crxguy52/pi-car-power-supply/tools/post_route/README.md

# tools/post_route: recorded edits to the master

These scripts are the record of each edit: pcbnew edits to `pi_power_board.kicad_pcb` (KiCad python, saved next to the `.kicad_pro`). **Run only a new script, or one marked re-runnable.** Every other script is history: re-run on today's master it stops at its guard at best, and at worst undoes later hand edits.

Each script: docstring = what, why, SPEC section; copies the master to `pi_power_board-backups/` with a timestamp first (no git); stops on any unexpected state; leaves every other item untouched; idempotent; every KiCad call under `timeout`.

State legend: **re-runnable** (safe to run again) · **applied-once** (record; stops at its guard) · **refuses** (blocks itself on the current master) · **historical** (kept for reference only).

| # | Script | What | State |
|---|---|---|---|
| 01 | `01_update_from_schematic.py` | Board from the schematic netlist (SPEC 7): K1/U2/R10 removed; every schematic footprint re-loaded from the library at its position (J1/J4/J5 Metz → Phoenix MKDS with identical pad coordinates, U3/U8/D1/D2/L1 swaps, KiCad 10 library drift); 44 new parts staged off-board; Path/Sheetname/fields; every pad net from the netlist; uuid5 uuids. DRC parity 0 | **historical** (names parts removed by the CD4541B design; its netlist export reads the live schematic: superseded by 05) |
| 02 | `02_placement.py` | Placement at 1206 (target list + courtyard legalizer, refdes on silk where free, J1/J4/J5 pin-name silk). Board full: R11/D1/D4/D5 parked off-board. **Superseded by 03**; its helpers (legalizer search, `place_refs`, pin labels) are imported by 03 | **historical** (a re-run would undo 03's placement: don't) |
| 03 | `03_0805_replace.py` | 31 passives swapped 1206 -> 0805 in place (01's helpers: fields, Path, nets, uuid5) and every movable part re-placed: anchors (buck, power path, SW1, C12, U4/C9) legalized from TARGETS, the rest by seeded annealing (net length + placement RULES + distance from TARGETS) and a staged legalizer; GAP 0.5 mm, fallback 0.25 mm. All 64 parts top side, 43 at >= 0.5 mm gaps (staff review 2026-11-04: C15/C18 targets swapped, C3 rule) DRC 0 violations, parity 0 | **historical** (its TARGETS name removed parts: stops at its guard; superseded by 06) |
| 04 | `04_buck_route.py` + `route_lib.py` | Routing attempt for the old 64-part design (A4, 2026-11-04 night), stopped by the project lead before it ran (board mtime = 03). **Never run; obsolete**: the simplified redesign (SPEC 7, 2026-11-04) removes most of the parts it routes | **historical** (never run: don't) |
| 05 | `05_sync_cd4541.py` | Board from the **frozen** netlist `build/placement_netlist_snapshot.xml` (44 parts, CD4541B design, SPEC 7; the schematic is not read): 36 old parts removed, 13 new added (Path, Sheetname/Sheetfile, fields; staged off-board), 13 re-loaded from the library (C22-C24 1206 -> 1210, changed values / nets / fields), every pad net set, Sim.* fields ignored; then J1, J4, J5 rotated 180 deg about their pad rows (lead decision 2026-11-05: wire entries outward; same pad locations, pin order reversed, nets follow pins). 01's helpers imported read-only. DRC parity 0 | **re-runnable** (prints "already applied") |
| 06 | `06_placement.py` | Placement of the 40 movable parts: ANCHORS (power corner Q1/C30/R14/TVS1, buck row U8/C17/C15/C22-C24/L1/C18) exact, the rest legalized from TARGETS (gap 1.0 mm, fallback 0.75 / 0.5 mm, staged search radius, outside the planned power channels); refs on silk where unambiguous, else F.Fab; J1/J4/J5 pin labels for the new pin order. `--dry-run [--out scratch.kicad_pcb]` never saves the master | **historical since 07** (a re-run would undo 07's turns and the C18 shift: don't; re-placing = a new script) |
| 07 | `07_placement_review.py` | Placement staff review fixes (2026-11-05): D4 Path re-linked to the snapshot symbol uuid (05 kept the old one: `fp_matches` doesn't compare Path); R30, D4, R3 turned 180 deg in place (pad toward the rest of its net; references kept where 06 put them); C18 0.5 mm down (U8 gap 0.53 -> 1.03 mm). Guarded on the 06 positions; `--dry-run` never saves | **re-runnable** (prints "already applied") |
| 08 | `08_lead_layout.py` + `lead_layout_2026-11-05.json` | The project lead's layout tweaks (32 parts moved in `pi-car-power-supply - Copy`): `--snapshot` (once) writes positions, rotations, ref/value text, Path and pad nets to the JSON; the apply mode moves the master's parts by reference, guarded (same refs, footprint ids, Paths, pad nets). J2 / J5 moved by the lead: baseline via `check_fixed.py --accept-lead-change J2,J5` (pure translation). ADJUST: R16 to the VSENSE side, D3 + R3 below the compensation parts, R15 above Q5, Q5 +0.5 mm, C19 -0.1 mm (DECISIONS "Lead layout adopted") | **re-runnable** (prints "already applied") |
| 09 | `09_buck_route.py` | Net classes / board rules in `.kicad_pro`; buck (hot loop, PH by vias, BOOT, VSENSE sense line along the GPIO-notch edge, FB / SS / COMP / CRC), power pours `BATT_TOP`, `VOUT_TOP`, `VOUT_BOT`, `P5V_TOP`, J2 VBUS necks, ACC_IN J1 -> TVS2 -> D5, TVS returns, Q1_G, Q1 tab vias (2 x 1.0 mm feed + 21 thermal) and a B.Mask opening over the tab; all locked | **applied-once since 12** (12 moved its sense line: a re-run stops at its "partly applied" guard; its BOARD_RULES copper-to-edge 0.3 mm is superseded by 12's 0.4 mm) |
| 10 | `10_freeroute.py` + `10_ledger.json` | GND fan-out vias (16 SMD pads), DSN (09 zones as keep-outs, completed nets reduced to one pin, BATT -> SW1 feed only, 0.5 mm), Freerouting 2.5.0 headless, SES import (locked copper checked unchanged) | **re-runnable** (prints "already applied") |
| 11 | `11_cleanup.py` + `11_ledger.json` | Review of the Freerouting output (neck-downs widened to 0.25 mm, its vias 0.6 / 0.3, snap, zero-length, acute angles, no Freerouting copper on power nets but the SW1 feed); J2 inner GND pin ties; `GND_TOP` / `GND_BOT` pours; 5 mm stitching grid; refs over pads / silk to F.Fab; all locked | **re-runnable** (prints "already applied") |
| 12 | `12_osh_rules.py` + `pi_power_board.kicad_dru` | Routing staff review (2026-11-05): fab = OSH Park 2-layer. Board Setup floors in `.kicad_pro` (copper to edge 0.4, track / space 0.1524, ring 0.127, drill 0.254, via 0.508, hole to hole 0.127, text 0.0762 mm), `.kicad_dru` min slot 0.508 mm, mask expansion 0.0762 / min web 0.1016 mm, stackup (text patch, 1.6256 mm), `+5V1` sense run 0.1 mm off the GPIO-notch edge, refill. Apply stage runs in a fresh process (a loaded project keeps the old rules for the fill). `--dry-run`; `--root DIR` (scratch copy); `--root DIR --selftest-dru` (proves the slot rule) | **re-runnable** (prints "already applied") |
| 13 | `13_right_notch.py` | Project lead decision 2026-11-05: the BACK HEADER KEEPOUT strip on the right edge cut out (x 185.166–192.024, y 70.450–102.000; inner fillets r 1.524, outer corners r 0.762; geometry recorded in `check_fixed.RIGHT_NOTCH_PATH`). Top cut edge 10 µm below the approved 70.440 so the MH2 neck is ≥ 5 mm (measured 5.009 top / 5.024 bottom mm). 7 GND stitching vias in the strip (x 189.47) deleted; 5 at x 184.47 next to the new inner edge moved to x 184.2 (edge gap 0.666 mm); J1 / J4 pin labels x 184.4 → 184.33 (edge gap 0.157 mm); refill; `check_fixed --accept-lead-change EDGE_RIGHT_NOTCH`. `--dry-run` | **historical since 14** (14 replaced its top edge: a re-run stops at its "partly applied" guard) |
| 14 | `14_notch_under_usb.py` | Project lead decision 2026-11-05 ("keep board under the USB port J2"): the notch's top edge moved from y 70.450 to `check_fixed.CUT_TOP_Y_USB` = 85.000, just below J2's courtyard (84.555; limit courtyard + 0.2 mm). The five top path items (right edge line, mouth arc r 0.762, top edge, inner fillet r 1.524, inner vertical line) replaced by `check_fixed.RIGHT_NOTCH_USB_TOP`, exact shared endpoints; bottom edge unchanged. Built and refilled in a scratch copy (`C:\tmp\pipwr\a19_14`), then copied over the master. 3 GND stitching vias back at x 189.47 (11's grid, y 70.89 / 75.89 / 80.89; edge, fill and hole checks). Necks 19.170 top / 5.024 bottom mm; J2 pad copper to edge 1.336 mm; J1 / J4 labels untouched. `check_fixed --accept-lead-change EDGE_RIGHT_NOTCH_UNDER_USB`. `--dry-run` | **re-runnable** (prints "already applied") |
| 15 | `15_sync_fields.py` | Final reconcile with the schematic (fresh netlist `build/netlist.xml`, exclude_from_board simulation parts skipped): Value (D3 `VFR1105W`, J5 `ACC_N GND`), Datasheet, Description, Manufacturer, MPN, Digi-Key PN and Sim.* (KiCad 10 parity compares them) copied onto every footprint; missing fields inserted hidden on F.Fab (silk unchanged); Path / Sheetname / Sheetfile checked against the netlist tstamps (all 44 matched). Guarded: footprint set, footprint ids, pad nets, positions unchanged; stops on a visible silk Value. 2026-11-05: 165 inserts, 72 updates, 2 values, 0 Paths; DRC parity 0. `--dry-run` | **re-runnable** (prints "already applied"; 2026-11-06 after 16: 46 footprints match) |
| 16 | `16_buck_layout.py` | U8 datasheet review (2026-11-06, SLVSCD5D 10.1): fields of L1 / R16 / R17 / R18 and new C31 / C32 from a fresh netlist (Path, fields, pad nets, uuid5); U8 + C17 + C15 + their copper moved as one block (−1.3, +9.205 mm) below J5; R16 / R17 at pin 5, R18 / C20 at pin 6, C19 at pin 8 (F.Cu); analog ground traces to the PowerPAD + rule area `AGND_KEEPOUT` (F.Cu, no fill); C18 at BOOT (PH via right of it), C31 below C15, C32 left of C22, L1 +1 mm; PH B.Cu re-run; old FB / COMP / CRC / SS / BOOT copper deleted; `+5V1` sense ends at R16; VOUT_TOP / P5V_TOP outlines; refs of moved parts, U8 Value and D3 ref to F.Fab; refill. DRC 0 errors / 0 unconnected / 0 parity; `check_fixed` PASS. `--dry-run`, `--root DIR` | **re-runnable** (prints "already applied") |
| 17 | `17_silk_refs.py` | Project lead review 2026-11-09, run after the lead's own GUI edits of the buck block (output caps left, L1 turned, third PH via, C17 / R17): every visible F.Fab reference to F.Silkscreen (0.8 / 0.12 mm), at the nearest spot clear of pads, vias, silk, other parts' bodies and the edge, then a second pass re-places any label nearer another part's courtyard than its own (staff review: U8 read as D3's, C31 as C18's); no spot = left on silk at the courtyard centre for the lead (C18, R16: DRC `silk_over_copper` warnings). Debris: 9 micro-segments (≤ 50 µm kinks / zero-length dots on GND, FB, PH, `U5_RS`, `ACC_G`) deleted with the neighbour ends snapped together (clearance-checked) and collinear contained segments; refill. DRC 0 errors / 0 unconnected / 0 parity; `check_fixed` PASS. `--dry-run`, `--root DIR` | **re-runnable** (prints "already applied") |
| 18 | `18_thermals.py` | Project lead 2026-11-09 (hand soldering without a preheat station for every part): every pour's pad connection THT-only / solid -> thermal relief (spokes 0.5 mm, gap 0.3 mm, unchanged); solid overrides on U8 (PowerPAD; VIN / GND hot loop), Q1 (tab heatsink), C17 (hot-loop input cap) and C32 pad 1 (one spoke fits at the P5V_TOP strip end: starved_thermal); refill. DRC 0 errors / 0 unconnected / 0 parity; `check_fixed` PASS. `--dry-run`, `--root DIR` | **re-runnable** (prints "already applied") |

**2026-11-05 routing:** 08 adopted the lead's layout, 09-11 routed the board (DRC 0 errors / 0 unconnected; DECISIONS "Routing"). Re-routing = restore the backup taken before 09 and re-run 09-11 (Freerouting's result is reproducible on the same input board, but check it), then 12. Staff review: 12 (DECISIONS "Fab = OSH Park", "Routing staff review").

Renders (no script; kicad-cli under timeout, from the project root): `pcb export svg --mode-single --page-size-mode 2 --exclude-drawing-sheet -l F.Cu,F.Mask,F.Silkscreen,Edge.Cuts` (bottom: `--mirror -l B.Cu,B.Mask,B.Silkscreen,Edge.Cuts`), rasterized with PyMuPDF to 2048 px wide -> `reports/routed_top.png` / `routed_bottom.png`; `pcb render --side top --width 1712 --height 1432 --quality high` -> `reports/routed_3d_top.png`.

**2026-11-05 CD4541B design:** 05 rebuilt the board from the frozen netlist snapshot, 06 placed it (DECISIONS 2026-11-05 "Placement") and 07 applied the placement staff review (DECISIONS "Placement staff review"). 01-04 and 06 are history.

Guard for every script here: `tools/check_fixed.py` (KiCad python) verifies Edge.Cuts, MH1–MH4, J1/J2/J4/J5 (position, orientation, side, absolute pad coordinates, 1 µm) and the lead's drawings / rule areas against `tools/fixed_baseline.json` (generated once on 2026-11-04 from the lead's board; the generator refuses to overwrite it). The only other way it changes is a recorded lead decision, `--accept-lead-change <refs>` (guarded: every other item must pass and the change must be exactly the recorded one; the JSON keeps a `lead_changes` record): used 2026-11-05 for `J1,J4,J5` (180 deg turn about the pad rows) and `J2,J5` (the lead's layout copy: pure translations by recorded vectors) and `EDGE_RIGHT_NOTCH` (13: only the right edge line replaced by the recorded notch path) and `EDGE_RIGHT_NOTCH_UNDER_USB` (14: only the notch's five top items replaced). `--selftest` mutates each item (48 mutations; the rule-area mutations only touch the lead's rule areas, so a later keep-out such as 16's `AGND_KEEPOUT` is allowed).

Related: `tools/render_assembly.py` (KiCad python, read-only): `reports/assembly_top.png`, the top-side assembly drawing at 4:1 and 200 dpi (reference + value in each courtyard, pad 1 marked) for hand soldering, since most references don't fit on the silkscreen.
