crxguy52/pi-car-power-supply/tools/post_sch/README.md

# tools/post_sch: recorded edits to the master

These scripts are the record of each edit: text-level edits to `pi_power_board.kicad_sch`. **Run only a new script, or one marked re-runnable.** Every other script is history: re-run on today's master it stops at its guard at best, and at worst undoes later hand edits.

Each script: docstring = what, why, SPEC section; copies the master to `pi_power_board-backups/` with a timestamp first (no git); stops on any unexpected state; leaves every other item untouched; idempotent; every KiCad call under `timeout`.

State legend: **re-runnable** (safe to run again) · **applied-once** (record; stops at its guard) · **refuses** (blocks itself on the current master) · **historical** (kept for reference only).

| # | Script | What | State |
|---|---|---|---|
| 01 | `01_spec7_netlist.py` | SPEC 7 netlist of the 64-part 555 / N-FET design: K1/U2/R10 removed, every part placed, label-based wiring, PWR_FLAGs, paper A3, block headers | **historical** (2026-11-04; superseded by 03; on today's SPEC and sheet it stops at its first guard) |
| 02 | `02_0805_footprints.py` | Footprint fields of 31 small-signal passives 1206 -> 0805 HandSolder (64-part design) | **historical** (2026-11-04 overnight; superseded by 03, which writes the SPEC 7 footprints; its refs are gone, so it stops at its guard) |
| 03 | `03_simplified.py` | Simplified SPEC 7 (32 parts + J1/J2/J4/J5/SW1; U1 LM2903B): the 33 removed parts and every old wire, label, no-connect and note go; the 34 surviving parts keep their symbol and pin uuids (board link); U1 (3 units), R23, R24 added; fields from SPEC 6/7; label-stub wiring; PWR_FLAGs on BATT, GND, VOUT, +5V1; paper A4, block headers with one note each. Self-checks grid, connectivity vs SPEC 7, overlaps, A4 frame / title block; `--dry-run` writes nothing | **applied-once** (2026-11-05; since 04 it stops at its first guard: SPEC 7 has D4) |
| 04 | `04_d4_sw1_diode.py` | D4 (1N4148W) restored between SW1 pin 1 (`SW1_C`) and `ACC_S` (schematic staff review: SW1 closed with `BATT` dead back-feeds the load through D5/SW1); sheet title. Uses 03's layout engine: only SW1 pin 1's stub/label are replaced; 03's checks plus a change-set check; `--dry-run` | **applied-once** (2026-11-05; since 05 it stops at its guard: the sheet is neither the 03 nor the 04 result) |
| 05 | `05_u1_power_block.py` | U1 -> project symbol `pipwr:LM2903` (`lib/pi_power_board.kicad_sym` + `sym-lib-table`, written by the script): stock `Comparator:LM2903` with a rectangle body on the power unit C (pin 4 named GND, pin 8 V+); U1C and C8 redrawn as one block (shared `BATT` wire, one GND). Keeps U1's symbol / pin uuids. Uses 03's engine with 04's layout; 03's checks plus a change-set check; `--dry-run` | **applied-once** (2026-11-05; since 06 it stops at its guard: the sheet is neither the 04 nor the 05 result) |
| 06 | `06_timer_45s.py` | 45 s timer (project lead: ≥ 45 s worst case after the last key-off): C27, C28 (10 µF 50 V X7R 1206, the C5 part) added in parallel with C5 on `C5_T`, right of C5, 18 grid units apart (value text width); R9 2.4 → 4.7 MΩ and moved right of them; C5 / C27 / C28 fields with the GMC31X7R106K50NT MPN; timer note. Uses 03's engine with 05's layout; 03's checks plus a change-set check; `--dry-run` | **applied-once** (2026-11-05; since 08 it stops at its guard: SPEC 7 has no C5 / C27) |
| 07 | `07_low_trip_timer.py` | Low-trip 45 s timer (staff review of 06): C28 removed, R4 / R5 / R23 / R24 values, R9 moved | **historical** (never applied: the LM2903B timer was superseded first; 08 removes C28 with the rest; on today's SPEC it stops at its first guard) |
| 08 | `08_cd4541_timer.py` | CD4541B counter timer (SPEC 7, 2026-11-05 lead decisions a–c): U1, R4, R5, R9, R23, R24, C5, C27, C28 removed with every wire, label and note; 31 surviving parts keep their symbol / pin uuids; U5 (`Timer:CD4541BM`, VDD / VSS drawn to the D7 / C8 block and GND), Q5, Q6, R25–R29, C29, C30, D7 added; C8 10 µF 1206 on `VDD_TMR`, C22–C24 X7R 1210; PWR_FLAG on `VDD_TMR`; blocks Input / ACC sense, Timer U5, P-FET switch, Status / LED / Pi 12 V, Buck, USB. 03's engine and checks plus a result check (uuids kept, removed refs / nets gone, lib_symbols); `--dry-run` | **applied-once** (2026-11-05; since 09 it stops at its guard: SPEC 7 has R30 / R31) |
| 09 | `09_u5_vout_supply.py` | U5 from `VOUT` (project lead 2026-11-05: the BAT43W + 10 µF hold-up on `+5V1` failed a hard USB short): D7 becomes the BZT52C5V1 zener (`Device:D_Zener`, same ref, symbol / pin uuids and SOD-123 footprint; pin 2 `+5V1` → GND), C8 10 µF 1206 → 1 µF 0805, R30 (1206, `VOUT` → `VDD_TMR`) and R31 (0805, `VDD_TMR` → GND) added; the `VDD_TMR` rail above U5 carries U5 VDD, C8, D7, R31 and R30 as one block; block note updated. 08's layout through 03's engine; 03's checks plus a result check (08 uuids kept, D7 lib_id, lib_symbols without `Diode:BAT43W-V`); `--dry-run` | **applied-once** (2026-11-05; since 10 it stops at its guard: the sheet is neither the 08 nor the 09 result) |
| 10 | `10_u5_value_field.py` | U5 Value field ("CD4541BM96") moved from above the body (where it read as C8's part number) to below it, right of the VSS pin (staff review of 08 / 09, legibility only). 09's layout through 03's engine; 03's checks plus a result check (only the U5 symbol's Value position changes, every uuid kept); `--dry-run` | **applied-once** (2026-11-05; a re-run reports "already applied"; any other state stops) |
| 11 | `11_remove_dangling_wire.py` | Remove the orphan wire stub left by the lead's layout tidy-up (master took the lead's rearranged sheet, 2026-11-05) | applied-once |
| 12 | `12_kicad_sim.py` | KiCad-native timer sim (TODO "KiCad-native simulation"): hidden `Sim.*` fields on 26 parts (R / C built-in with numeric values, R27 / C29 / C8 with the corner factors; diodes, FETs and U5 from `lib/spice/`), `exclude_from_sim` on U8, the buck / USB passives, J1, J2, J4, J5, SW1; a sheet symbol `simulation` (excluded from board and BOM) at the bottom middle, six pins stub-wired to labels `BATT`, `ACC_IN`, `SW1_C`, `VOUT`, `ACC_N`, `+5V1`; new `simulation.kicad_sch` (battery + harness, ACC key, SW1 stand-in, Pi load, Pi GPIO pull-up, U8 stand-in, `.param` / `.tran` / `.meas`); `pipwr:SIM_2T` / `SIM_3T` in `lib/pi_power_board.kicad_sym`. Text-level, no existing item moved or changed beyond those fields (checked: uuids, positions, lib_ids, the free area); seeded uuid5; `--dry-run` | **applied-once** (2026-11-05; a re-run reports "already applied", also after 13 (guard extended by the staff review); any other state stops) |
| 13 | `13_sim_fast_review.py` | Staff review of 12: U5 `Sim.Params` + `TAPDIV={U5_TAPDIV}` (hidden Sim field only); the sim sheet's note / `.param` / analysis texts replaced in place (same uuids, positions): defaults = the fast nominal key cycle (U5 counts 2^15 / 256, 6 s transient, no interp), measurement windows as parameters (`T_CW0`, `T_CW1`, `T_VON0`), new `.meas` `u5_fall`, `osc_t1/2`, `t_osc`, `hold_est`, new `.param` `U5_TAPDIV`, `N_CNT`, `CGD_FAC`, `CIN_U8`. Accepts only 12's exact result; `--dry-run` | **applied-once** (2026-11-05; a re-run reports "already applied"; any other state stops) |
| 14 | `14_bom_fields.py` | Phase 6 BOM: Manufacturer / MPN / `Digi-Key PN` (cut tape; U8 tube; THT bulk / tray) / Description / Datasheet (`${KIPRJMOD}/ref/datasheets/...`; J2 the Molex URL) on all 44 board refs from its `PARTS` table (= SPEC 6, checked against the SPEC Digi-Key PN / Manufacturer / MPN columns); J5 Value "GND ACC_N" -> "ACC_N GND" (lead decision). Field values only (missing Manufacturer / MPN / Digi-Key PN inserted hidden at the symbol origin); a result check keeps everything else byte-identical; `--dry-run` | **applied-once** (2026-11-05; a re-run reports "already applied"; any other state stops, including a later field edit: change parts in a new script) |
| 15 | `15_bom_review.py` | BOM staff review: D3 -> Stanley VFR1105W-6C9-TR (−40 to 100 °C; Value "VFR1105W", SPEC 7), C29 -> Murata GCM21B5C2E103FX0AL (C0G ±1 %, 250 V, AEC-Q200; Value kept): Manufacturer / MPN / `Digi-Key PN` / Description / Datasheet. Imports 14's helpers; SPEC 6 / 7 must carry the new values first; each field must hold 14's value or the target; a result check keeps everything else byte-identical; `--dry-run` | **applied-once** (2026-11-05; a re-run reports "already applied"; any other state stops). 14 now stops at its SPEC check (SPEC 6 has the 15 values) |
| 16 | `16_buck_fixes.py` | U8 datasheet review (2026-11-06, `reports/ic_review.md`): L1 SRP1038A-150M, R16 73.2 k, R17 13.7 k, R18 7.32 k (Value / MPN / Digi-Key PN / Description); C31 (copy of C15) and C32 (copy of C22) added below C19 / C20 with label-stub wiring and #PWR27 / #PWR28; header "BUCK 5.07 V"; `simulation.kicad_sch` U8 stand-in .param (V5SET 5.07, C5V1 64u, CIN_U8 10u, RFB 86.9k). uuid5 for the new items, every old uuid kept; result check: removing the inserts and blanking the edited fields gives the old sheet; `--dry-run` | **re-runnable** (prints "already applied") |

Related tools: `tools/build_lib.py` (`pdm run build-lib`, re-runnable: project footprints `pipwr`), `tools/check_netlist.py` (`pdm run check-netlist`, `--selftest`), `tools/verify_sch.py` (`pdm run verify-sch`: ERC + netlist + selftest + `reports/schematic.pdf/.png` + PDF text-overlap check on every page + the sim), `tools/run_sim.py` (`pdm run sim`: every timer scenario from the schematic with KiCad's ngspice, fast mode, deck elements sorted by name since 2026-11-06 so convergence does not depend on the sheet's item order; `--full` real time; `--selftest` broken decks; `reports/sim_kicad.md`), `tools/sch_lib.py` (library symbol flattening and pin geometry).
