crxguy52/pi-car-power-supply/reports/overnight_state.md

# Overnight run 2026-11-04: placement + routing (unattended)

Project-lead instruction (2026-11-04, evening): do placement and routing overnight. **Do not change** the board outline, the mounting holes, or the positions of anything that leaves the board: screw terminals J1, J4, J5 and USB J2. Keep the lead's drawn keep-outs and reference text (GPIO HEADER, WAVESHARE IO, PoE, BACK HEADER KEEPOUT, RJ45/USB outlines). No questions: conservative choice + recorded assumption. No commits (the lead commits).

| Time | Step | Result |
|---|---|---|
| 2026-11-04 | Project moved Drive → C:\git-personal\pi-car-power-supply (checksums identical); pdm venv rebuilt; check-toolchain 5/5 PASS; verify-sch PASS; DRC baseline: 44 missing_footprint, 87 net_conflict, 57 unconnected (board not yet updated from schematic) | ok |
| 2026-11-04 19:31 | A3: tools/check_fixed.py + fixed_baseline.json (24 Edge.Cuts, 20 drawings, 1 rule area, MH1-4/J1/J2/J4/J5 pads) | PASS on the lead's board; selftest 48/48 |
| 2026-11-04 19:38 | A3: tools/post_route/01_update_from_schematic.py (K1/U2/R10 removed, 67 footprints from library, 44 new staged off-board, nets from netlist) | DRC parity 0 (was 171), lib_footprint_mismatch 0, check_fixed PASS; re-run = already applied; two runs from the lead board byte-identical (uuid5 + resave); lead board backup pi_power_board-backups/pi_power_board_2026-11-04_193829.kicad_pcb |
| 2026-11-04 20:45 | A3: tools/post_route/02_placement.py (placement) | 60 of 64 movable parts placed, R11/D1/D4/D5 parked off-board (board full: courtyards 1387 mm² in 1810 mm² free, 1535 mm² at 0.25 mm gaps); DRC 0 violations, 0 parity, 133 unconnected; check_fixed PASS, selftest 48/48; re-run = already applied |
| 2026-11-04 night | Coordinator decision (conservative, lead away): board full → small-signal passives to 0805 HandSolder (allowed by the lead's rules); power-path passives stay 1206; smaller electrolytics only if ripple/ESR checks pass; bottom-side 0805 only as last resort; keep-outs untouched | decided |
| 2026-11-04 night | Coordinator decision: terminal wire-entry direction (A3: J1/J4/J5 entries may face inward, J4 blocked by J1) NOT changed: lead's hard constraint; flagged for the morning (TODO lead item) | decided |
| 2026-11-04 20:53 | A3b: SPEC 5/6/7 + DECISIONS: 31 small-signal passives 1206 -> 0805 HandSolder (R13, R21, C5/C6, C11, C14, C15/C16, C22-C24 stay 1206); tools/post_sch/02_0805_footprints.py | applied; re-run = already applied; verify-sch PASS (ERC 0, netlist 0 errors, selftest 15/15) |
| 2026-11-04 21:43 | A3b: tools/post_route/03_0805_replace.py (0805 swap in place + re-placement, seeded annealing + staged legalizer) | 64/64 parts on the board, top side; 38 at >= 0.5 mm gaps, rest 0.25-0.48 mm; DRC 0 violations, 0 parity, 133 unconnected; check_fixed PASS, selftest 48/48; re-runs of 01 and 03 = already applied |
| 2026-11-04 21:45 | A3b: Freerouting 2.5.0 trial on a scratch copy (not written to the board) | GND to pours, power 0.6 mm: 0 unrouted; power 0.8 mm: 2 (+5V1 at J2); GND as tracks: 7 |
| 2026-11-04 21:45 | A3b: reports/placement_top.png (3D render), reports/assembly_top.png (tools/render_assembly.py); READMEs, CLAUDE.md phase 4, TODO 4 updated | done; staff review pending |
| 2026-11-04 22:05 | Staff review (0805 split + 03): split confirmed against SPEC 4; 03 TARGETS C15/C18 swapped (C15 VIN loop), RULE C3 at the Q4 gate, named SPREAD_AREA_WEIGHT; 03 re-run (backup pi_power_board-backups/pi_power_board_2026-11-04_215737.kicad_pcb) | 64/64 top side, 43 at >= 0.5 mm; DRC 0 violations, 0 parity, 133 unconnected; check_fixed PASS, selftest 48/48; verify-sch PASS; re-run of 03 and post_sch/02 = already applied; Freerouting trial (scratch, 0.6 mm power, GND to pours) 0 unrouted; assembly_top.png re-rendered |
| 2026-11-04 ~23:00 | Lead stopped A4 (routing): "too many parts (64), shouldn't be complicated; I chose a comparator that runs at 12 V". A4 wrote tools/post_route/04_buck_route.py + route_lib.py but never ran them (board mtime 21:57 = A3b) → orphaned, mark historical | stopped |
| 2026-11-04 ~23:00 | Lead: "take another shot at the schematic" (overnight, unattended). Coordinator plan: drop the 555; LM393 dual does delay (RC decay vs BATT/2 ref, hysteresis) + ACC status (open collector → J5); LM393 on BATT; Q1 gate driven by U1A directly; 1 TVS; no electrolytics; buck → TPS54302 SOT-23-6 if thermally OK else keep TPS54336A. Part budget ~35; additions only for a named, datasheet-backed failure mode. Schematic only: no placement/routing tonight | decided |
| 2026-11-04 23:40 | A6: simplified redesign on paper: SPEC 2-4/6/7 rewritten (32 parts + J1/J2/J4/J5/SW1; U1 LM2903BIDR on BATT does delay + ACC status; TPS54336A kept, TPS54302 rejected on thermal), DECISIONS (33 rows superseded, 15 new), TODO rewritten, tools/design_calc.py rewritten, ltspice/delay_off_lm393.cir + reports/sim_delay_off_lm393.md, post_route README (04 never run). Backups pi_power_board-backups/*_2026-11-04_231351.* | sim 18 steps + SW1 run: short corner 11.8-13.0 s, nominal 17.5-20.5 s, long 23.2-27.5 s, no chatter/re-latch; calc worst 11.2 s; dk-selftest PASS; dk-check: 13 MPNs active + stocked (FAILs = missing DK PNs/strings); schematic/board not touched; staff review pending |
| 2026-11-04 23:55 | Staff review (simplified redesign): pins/footprints/connectors vs PDFs and KiCad 10 libs OK; scenarios traced; no part or value changed (32 parts). Fixes: C5 aging 5 % in the short stack (calc 10.7 s, sim 11.2 s worst), C5 insulation need restated (>= 25 MOhm hot), buck loop with datasheet Roea/Coea (PM >= 51 deg), inrush half-Qgd bound in SPEC (866 W vs 1.2 kW), cranking/back-feed/LED-temperature/key-on-during-delay notes + TODO. Sim re-run (18 steps + SW1, no chatter/re-latch). Second-pass review: 2 wording fixes. Backups *_2026-11-04_234817.* | ok |
| 2026-11-05 00:20 | A7: tools/post_sch/03_simplified.py (simplified SPEC 7 schematic, A4; 33 parts removed, 34 surviving uuids kept, U1/R23/R24 new); check_netlist selftest spot checks moved off U4; backup pi_power_board-backups/pi_power_board_2026-11-05_000734.kicad_sch | verify-sch PASS: ERC 0 errors / 0 warnings, netlist 0 errors, selftest 15/15, PDF overlap 0; re-run = already applied; staff review pending |
| 2026-11-05 00:40 | Staff review (schematic, 03): pins/pads/datasheets, netlist trace vs SPEC 2-4, ERC config (template defaults, no exclusions), PWR_FLAGs, uuids (34 kept), 03 re-run = already applied. Finding: SW1 closed with BATT dead back-feeds the load through D5 (300 mA) / SW1 (100 mA) -> D4 1N4148W restored (SPEC 2/3/6/7, DECISIONS, TODO lead item) by tools/post_sch/04_d4_sw1_diode.py (backup pi_power_board-backups/pi_power_board_2026-11-05_002710.kicad_sch; docs *_2026-11-05_002400.*); SW1 sim re-run with D4: 11.2-26.9 s; check_netlist selftest +4 U1/D4 mutations; title block; second agent reviewed 04: no defects | verify-sch PASS: ERC 0/0, netlist 0 errors (38 parts), selftest 19/19, PDF overlap 0; 04 re-run = already applied; 03 now stops at its guard |
| 2026-11-05 evening | Lead: "stepping away, run unattended". Plan: (1) A17 right-edge notch (approved: cut y 70.44–102.0, x 185.166–192.024, ≥ 5 mm necks; board only) ∥ R14 sim review resumed (schematic/sim only); (2) coordinator reconcile: J5 Value → "ACC_N GND", sync Sim.* fields to footprints, final DRC + check_fixed + verify-sch; (3) BOM phase (Digi-Key, datasheets, fields) + staff review; (4) morning summary here. No commits | started |
| 2026-11-05 18:08 | A17: tools/post_route/13_right_notch.py (lead's right-edge notch, x 185.166–192.024, y 70.450–102.000; necks 5.009 / 5.024 mm; 7 GND vias deleted, 5 moved to x 184.2; J1/J4 labels −0.07 mm x); check_fixed EDGE_RIGHT_NOTCH lead change; backup pi_power_board-backups/pi_power_board_2026-11-05_180225.kicad_pcb | DRC 0 errors / 0 unconnected; 2 silk_edge_clearance warnings (J4 accepted, J2 new); 26 Sim-field parity notes; check_fixed PASS, selftest 48/48; re-run = already applied |
| 2026-11-05 19:20 | A18 phase 6 BOM: 35 MPN rows / 44 refs, every MPN + cut-tape Digi-Key PN final (passives Vishay CRCW e3, KEMET, Cal-Chip GMC; C15 GMC31X7R106K50NT, U8 tube); tools/post_sch/14_bom_fields.py (fields on 44 refs, J5 Value "ACC_N GND"; backup pi_power_board-backups/pi_power_board_2026-11-05_190054.kicad_sch); 3 datasheets added (Vishay CRCW, KEMET X7R / C0G), J2 URL only; digikey_lookup.py spares + value checks; bom/ PIPWR_BOM.md, PIPWR_BOM_digikey.csv ($136.64, 2 boards + spares), assembly_checklist.md; SPEC 6, TODO, DECISIONS; docs backups *_2026-11-05_185216.* | dk-check PASS 35/35; dk-selftest PASS; verify-sch PASS (ERC 0, netlist 0 errors, selftest, PDF overlap, sim 14/14 + 6/6); 14 re-run = already applied; board not touched (fields to sync) |
| 2026-11-05 19:25 | A19: tools/post_route/14_notch_under_usb.py (lead: keep board under J2): notch top edge 70.450 → 85.000 (J2 courtyard bottom 84.555), bottom 102.000 unchanged; necks 19.170 top / 5.024 bottom mm; 3 GND stitching vias re-added at x 189.47 (y 70.89 / 75.89 / 80.89); check_fixed EDGE_RIGHT_NOTCH_UNDER_USB lead change; renders re-made; backup pi_power_board-backups/pi_power_board_2026-11-05_191942.kicad_pcb | DRC 0 errors / 0 unconnected; 1 warning (J4 silk; J2 silk warning gone); parity 45 BOM-field notes (44 Digi-Key PN / Manufacturer fields + J5 value, board not yet synced); check_fixed PASS, selftest 48/48; 14 re-run = already applied |
| 2026-11-05 19:45 | BOM staff review (A18 review): D3 -> Stanley VFR1105W-6C9-TR (-40 to 100 degC) and C29 -> Murata GCM21B5C2E103FX0AL (C0G 1 %, AEC-Q200) by tools/post_sch/15_bom_review.py (backup pi_power_board-backups/pi_power_board_2026-11-05_192919.kicad_sch); dk-bom CSV ASCII guard (digikey_lookup.py); SPEC 3/4/6/7, assembly checklist, DECISIONS, TODO; J2 Molex PDF still blocked; second staff review: text fixes only | dk-check PASS 35 rows, dk-selftest PASS, verify-sch PASS (ERC 0/0, netlist + selftest, PDF overlap, sim 14/14 + 6/6); BOM $116.48 (was $136.64) |
| 2026-11-05 19:55 | A20 final reconcile: tools/post_route/15_sync_fields.py (fresh netlist; 44 footprints: 165 fields inserted hidden on F.Fab incl. Sim.*, 72 updated, Values D3 VFR1105W / J5 "ACC_N GND", Paths all matched; backups pi_power_board-backups/pi_power_board_2026-11-05_194716 / _194811.kicad_pcb). Final: DRC 0 errors / 0 unconnected / 0 parity + accepted J4 silk_edge_clearance; check_fixed PASS, selftest 48/48; verify-sch PASS; dk-check PASS (35 rows); 15 re-run "already applied". Renders refreshed. Next: lead review (TODO "Lead review"). |
| 2026-11-05 night | **Run complete.** Right-edge notch (y 85.0–102.0, necks 19.2 / 5.0 mm, board kept under J2); KiCad-native sim reviewed (verify-sch 91 s, sim --full 23.5 min, 14/14 + selftest 6/6); BOM ($116.48 for 2 boards + spares, 35 MPN rows, dk-check PASS; D3 → Stanley −40…100 °C LED, C29 → Murata C0G); fields synced to the board. Final: DRC 0 errors / 0 unconnected / 0 parity (only the accepted J4 silk warning), check_fixed PASS, verify-sch PASS, dk-check PASS. IC review report: reports/ic_review.md (flags, not fixed: U8 K_IND 0.34 > 0.3, Cin ripple 441 > 400 mV, Cout margin thin, Vout worst 5.252 V > 5.25 V, FB divider ~12 mm from pin 5, COMP on bottom 1.37 mm from PH; U5 k tolerance not in datasheet → bench; buck_design.md stale). Nothing committed | done |
| 2026-11-06 morning | A22 U8 datasheet fixes (reports/ic_review.md flags): SPEC 4/5/6/7 first; design_calc buck() rewritten (L1 15 µH K_IND 0.23; C31 Cin 227 mV; C32 Cout margin 35 %; R16/R17 73.2k/13.7k 5.074 V, 4.915–5.238 V; R18 7.32k, PM ≥ 51°, fc 16–42 kHz); tools/post_sch/16_buck_fixes.py (+ sim stand-in params; run_sim.py sorts deck elements: 2 scenarios had stopped converging after the insert); tools/post_route/16_buck_layout.py (U8 block below J5, FB/COMP/SS at their pins on F.Cu, AGND traces + keep-out, refill); check_fixed selftest limited to the lead's rule areas. DRC 0/0/0 + J4 warning, check_fixed PASS + 48/48, verify-sch PASS, dk-check PASS, BOM $121.32; renders and ic_review crops redone; buck_design.md rewritten | done; staff review next |
