crxguy52/pi-car-power-supply/docs/DECISIONS.md

# Decisions: Pi power HAT

Decisions a later reader might reverse without knowing why. Current design: [SPEC.md](SPEC.md). Change a decision in the spec first, then here.

| Decision | Reason | Date | Spec |
|---|---|---|---|
| **P-FET high-side switch instead of the G6E relay (K1)** | The Pi 5 plus the buck draw ~3.5 A, over the G6E contact rating (2 A at 30 VDC, Omron datasheet). The K1 symbol was the latching G6EU, which would never release. A FET has no coil current and no contact wear | 2026-11-04 | 2, 4 |
| **Delay-off 555: TRIG + THRES on C5, RESET on VCC, LM397 discharges C5 while ACC is on; DIS not connected** | **Superseded 2026-11-04 (simplified redesign, project lead).** The old wiring tied TRIG and RESET to the comparator output, so RESET was held low at key-off: no delay. The new topology restarts the full delay on every key-off and survives a key-on mid-delay. DIS tied to C5 makes the 555 astable (sim: VOUT never turns off) | 2026-11-04 | 3 |
| **R9 2.4 MΩ instead of the value giving 14 s nominal** | **Superseded 2026-11-04 (simplified redesign, project lead).** With 2.2 MΩ the worst-case stack (C5 tolerance and temperature, 555 TRIG current, SE555 threshold-ratio limit) gave 9.75 s < 10 s. 2.4 MΩ gives 16.9 s nominal; a longer hold only keeps the Pi powered a few seconds more. R9 stays well under the NE555 datasheet's bias-current limit (≈ 3.4 MΩ at 5 V, 10 MΩ at 15 V) | 2026-11-04 | 3 |
| **R9 worst case corrected: 9.6 s at 9 V BATT, not 10.6 s** (staff review) | **Superseded 2026-11-04 (simplified redesign, project lead).** The 10.6 s figure used the SE555 threshold ratio at 15 V (9.4/15) at every BATT. The datasheet's 5 V limits are wider (2.7/5); interpolated to the 8.25 V logic VCC of a 9 V battery the minimum ratio is 0.59, giving 9.6 s. R9/C5 unchanged pending the lead (TODO: R9 1.2 MΩ + 2 × 10 µF gives 10.0 s) | 2026-11-04 | 3 |
| **DCL (C5 → VCC_LOGIC clamp) in the design and on by default in the sim** (staff review) | **Superseded 2026-11-04 (simplified redesign, project lead).** Without it, C5 sits up to 8.8 V above the collapsed VCC (555 abs max: THRES/TRIG ≤ VCC). With it, C5 stays within a diode drop of VCC, which also keeps THRES above 2/3·VCC (reset) through the collapse: the guaranteed no-re-latch argument. Delay change 0.02 s. Low-leakage silicon, not Schottky: reverse leakage adds to R9's current | 2026-11-04 | 3 |
| **Sim corner 4 (LM397 output leakage at its 1 µA limit) and SW1 force-on run added** (staff review) | **Superseded 2026-11-04 (simplified redesign, project lead).** The plan asked for worst-case delay and sensible behaviour; leakage sunk from C5 can stall the timer (found: never times out at 9 V), and SW1 was not simulated. Re-latch counting uses U2 VIL 0.9 V, not 1.2 V: U2 may switch anywhere between VIL and VIH | 2026-11-04 | 3 |
| **U3 IN− from an ACC divider (RS 33 kΩ / R8 47 kΩ)** | **Superseded 2026-11-04 (simplified redesign, project lead).** LM397 common-mode range ends at V_S − 1.5 V (V_S − 2 V hot); ACC directly, or a 10k/47k divider, exceeds it at 14.4 V | 2026-11-04 | 3 |
| **ACC status to the Pi through U2 OUT3 (open drain)** | **Superseded 2026-11-04 (simplified redesign, project lead).** Superseded 2026-11-04: Q4 2N7002BK open drain (U2 removed). The Pi's pull-up sets the level, so the GPIO never sees more than 3.3 V without a clamp; uses a spare U2 channel. Alternative rejected: divider plus a BAT54 clamp to Pi 3V3 through a 3-pin J5 | 2026-11-04 | 2 |
| **TVS on BATT and ACC; 100 Ω + 15 V zener on the logic VCC** | **Superseded 2026-11-04 (simplified redesign, project lead).** Car supply transients; the 555 is the lowest-rated part (VCC 18 V abs max) | 2026-11-04 | 2, 4 |
| **USB D+ shorted to D− per port** | Dedicated charging port signature: phones draw more than the default 500 mA | 2026-11-04 | 4 |
| **KiCad 10 migration (one way)** | Same toolchain as the reference workflow; files saved in 10 don't open in 9. KiCad 9 copy: `pi_power_board-backups/pre_kicad10_2026-11-04.zip` | 2026-11-04 | - |
| **No git** | Project lead's choice. History = dated backups in `pi_power_board-backups/` plus the docstrings of `tools/post_sch/`, `tools/post_route/` scripts | 2026-11-04 | - |
| **Sim gate (project lead): R9 1.2 MΩ, C5 = 2 × 10 µF** | **Superseded 2026-11-04 (simplified redesign, project lead).** Supersedes R9 2.4 MΩ / 1 × 10 µF: the old values stall at 9 V with LM397 output leakage at its datasheet limit and give a 9.6 s worst case. New: ~17 s nominal, 10.0 s worst case, no stall | 2026-11-04 | 3 |
| **Sim gate (project lead): SW1 acts like the key** | SW1 + D4 drive the ACC sense node (comparator input, U2 IN3 status to the Pi, OR input) instead of the driver input directly. Opening SW1 then gives the Pi a normal shutdown signal plus the full delay; previously it cut VOUT instantly and the Pi never saw ACC on | 2026-11-04 | 2, 3 |
| **Sim gate (project lead): DCL clamp diode fitted; U2 kept** | **Superseded 2026-11-04 (simplified redesign, project lead).** U2 part superseded 2026-11-04 (project lead: discrete N-FETs). DCL: see the staff-review row. U2 COM draws 17 µA typ / 30 µA max from BATT (SLRS073A 6.5), ~22 mAh/month: negligible | 2026-11-04 | 2, 3 |
| **ACC sense node `ACC_S`: J1 ACC (D5) and SW1 (D4) diode-ORed; its two dividers (37 kΩ) are the pull-down** | **Superseded 2026-11-04 (simplified redesign, project lead).** Implements the lead's "SW1 acts like the key": one node feeds U3 IN−, U2 IN3 (status) and D1, so SW1 and the key behave identically (sim). No separate pull-down resistor: the dividers already discharge the node and an extra resistor only loads ACC | 2026-11-04 | 2, 3 |
| **OR and sense diodes 1N4148W (silicon) instead of SS14 (Schottky)** | **Partly superseded 2026-11-04 (simplified redesign): only D5 survives (1N4148W, ACC_IN to ACC_S).** They carry ≈ 1 mA. Schottky reverse leakage (typically orders of magnitude above silicon when hot; SS14 not quantified, no datasheet in `ref/`) from `OR_N` into `ACC_S` would lift the 37 kΩ sense node and fake "ACC on"; 1N4148W leaks ≤ 25 nA at 20 V (25 °C), ≈ 1 µA hot → 37 mV | 2026-11-04 | 2, 6 |
| **DCL = BAV116W (SOD-123)** | **Superseded 2026-11-04 (simplified redesign, project lead).** Superseded 2026-11-04: BAS116LT1G (project lead). Low-leakage silicon (5 nA at 75 V, 80 nA at 125 °C, ds30291). Its leakage shortens the delay: the 125 °C limit costs 0.2 s in the worst-case stack (sim corner 1). SOT-23 parts are stocked but the brief asks for SOD-123 or bigger | 2026-11-04 | 3 |
| **Q1 SQD50P04-13L; gate R14 100k / R15 47k, C14 22 nF G-D, C13 470 nF G-S, DZ2 12 V** | **Superseded 2026-11-04 (simplified redesign, project lead).** Q1: −40 V, R_DS(on) specified at −4.5 V (22 mΩ max), DPAK, AEC-Q101, stocked. The gate drive is only −6.1 V at 9 V. C14 limits the key-on slew to ~7 V/ms: inrush ≤ 5.4 A into 580 µF instead of tens of A. C13 ≥ 20 × C14 keeps a battery hot-plug step from coupling the gate on through C14 (−0.8 V at 16 V vs V_TH 1.5 V min). The resistors were scaled ×10 from the sim-gate values so the capacitors stay small 1206 parts | 2026-11-04 | 4 |
| **TVS SMBJ16A on BATT and ACC** | Lowest standoff ≥ 16 V; V_C 26 V at 23 A is below the buck's 30 V VIN abs max, the lowest downstream rating. SMBJ18A clamps at 29.2 V: too close to 30 V. Not rated for a full ISO 7637 load dump (TODO) | 2026-11-04 | 4 |
| **DZ1 = SMAZ15 (1 W SMA), not a 500 mW SOD-123 zener** | **Superseded 2026-11-04 (simplified redesign, project lead).** Superseded 2026-11-04: 1SMA5928BT3G 13 V (TLC555 VDD range). At the 26 V TVS clamp it carries ~98 mA (1.6 W pulse) and holds V_Z ≤ 16.2 V < 18 V 555 abs max; the SMA part has the margin and its Z_ZT is specified at 50 mA | 2026-11-04 | 4 |
| **Bulk: ceramic on BATT (C11 10 µF), electrolytic on VOUT (C12 100 µF)** | **Superseded 2026-11-04 (simplified redesign, project lead).** BATT is always live: an Al electrolytic's leakage would add to the parked drain. VOUT is switched, so the electrolytic's ESR can damp the buck input and harness there at no parked cost | 2026-11-04 | 4 |
| **Buck: L1 10 µH SRP1038A-100M, Cout 3 × 47 µF, Type 2A comp 5.49k / 15 nF / 100 pF, SS 10 nF, EN UVLO 220k / 43.2k (7.1 V on / 6.2 V off)** | **Partly superseded 2026-11-04 (simplified redesign): L1, Cout 3 x 47 uF, R18/C20, SS 10 nF kept; C21 (Type 2A pole), the EN UVLO divider and the USB electrolytics removed.** Datasheet SLVSCD5D equations (`reports/buck_design.md`). I_sat 12 A exceeds the 6.5 A current limit (no saturation in a short). Cout DC-bias derating assumed from the TI example measurement (34 %); fc 5–41 kHz, PM ≥ 46° over the checked range. EN divider: defined EN and ≤ 5.1 V on EN at 30 V | 2026-11-04 | 4, 7 |
| **No per-port polyfuse on J2** | The buck's cycle-by-cycle limit, hiccup and thermal shutdown already protect the board; a polyfuse would only isolate one port's fault at a 0.1–0.2 V VBUS drop | 2026-11-04 | 4 |
| **U8 project footprint with a 1.0 mm centre plated hole** | Project rule: exposed pads only with a bottom solder via. 1.0 mm leaves ≥ 0.55 mm overlap on the 2.11 mm minimum exposed pad | 2026-11-04 | 7 |
| **R6/R7/C3 re-used as the U2 IN3 divider (R7 13 k → 22 k)** | **Superseded 2026-11-04 (simplified redesign, project lead).** Superseded 2026-11-04: Q4 gate divider, R7 47 k. IN3 ≥ 1.5 V needs ACC_S ≥ 5.2 V (with the 10 µA input current); 22 k gives 2.65 V at a 9 V battery and 4.9 V at 16 V | 2026-11-04 | 2, 7 |
| **No reverse-battery protection on the board (agent assumption)** | Body diode plus the unidirectional TVS conduct; the harness fuse is the protection. Adding it (e.g. a second back-to-back P-FET) is a lead decision (TODO) | 2026-11-04 | 4 |
| **U3 trip point lowered: R4 47 kΩ → 68 kΩ (trip at ACC_S < 0.70·VOUT, was 0.85·VOUT)** (staff review 2) | **Superseded 2026-11-04 (simplified redesign, project lead).** At 9 V the old trip left 0.64 V between ACC_S and the trip point. If ACC at the board sags that much while the key is on, the timer runs out with ACC still on (D1 holds VOUT), and the real key-off then cuts VOUT with no delay. New margin 2.0 V. IN+ stays inside the LM397 common-mode range; key-off detection is unaffected (ACC_S falls to 0). Sim re-run: all results unchanged | 2026-11-04 | 3, 7 |
| **Terminal blocks: Phoenix MKDS 1/x-3,81 (1727023 / 1727010) instead of Metz RT0340xHBLC** (staff review 2) | Metz shows 0 Digi-Key stock with MOQ 5000. Phoenix: same 3.81 mm pitch and pin order, stocked, 10 / 13.5 A, AWG 16–30 (Metz: AWG 18 max stranded), KiCad 10 footprints exist. Ratings from Digi-Key parameters (datasheet 403) | 2026-11-04 | 6, 7 |
| **Orderable MPNs: J2 0484060001, SW1 CAS-120TA** (staff review 2) | Digi-Key doesn't find "48406-0001"; CAS-120A1 shows 0 stock. CAS-120TA is the same J-hook CAS-120A on tape (washable type with seal tape) and fits the same KiCad footprint; pad 2 = common checked on the Nidec catalogue | 2026-11-04 | 6, 7 |
| **U8 footprint: 6 more thermal vias under the masked ends of pad 9, bottom pad 4.0 × 6.0 mm** (staff review 2) | 4 unfilled 0.3 mm vias are about 45 °C/W from pad to bottom, comparable with the whole JEDEC RθJA, on a 2-layer board running about 1 W at 3 A. 10 vias plus the solder-filled 1.0 mm centre hole: about 10 °C/W. The extra vias are tented on top so they don't draw solder from the exposed pad; the larger bottom pad gives the iron contact and the pour joint. The 1.0 mm centre hole stays | 2026-11-04 | 7 |
| **Timer worst case recomputed: 9.46 s at 9 V (R9 1.2 MΩ), stall limit 1.74 µA** (staff review 2) | **Superseded 2026-11-04 (simplified redesign, project lead).** The 9.8 s figure scaled a sim corner that uses R9 nominal; R9 −1 % is added in `tools/design_calc.py` `timer()`. The stall limit must use the SE555 threshold at its highest ratio (0.745 at 8.26 V), not 2/3: (VCC − V_THRES)/R9, not VCC/(3·R9). It sets a C5 + C6 insulation requirement (≥ 12.6 MΩ hot) that typical MLCC guarantees don't meet: BOM / bench item. R9 stays 1.2 MΩ (lead gate) | 2026-11-04 | 3 |
| **Q1 SOA basis: 674 µF on VOUT** (staff review 2) | Pi regulator input assumed 2 × 47 µF ceramic plus a 470 µF bulk, plus C12 and the buck input. At 16 V: 7.4 A, 118 W peak, 86 mJ, against about 180 W on the 1 ms SOA line derated to TC 85 °C. Turn-off is not a light load in general (USB charging continues): about 35 mJ, inside the 10 ms line. Gate values unchanged | 2026-11-04 | 4 |
| **Project lead: R9 1.3 MΩ (supersedes the 1.2 MΩ sim-gate value)** | **Superseded 2026-11-04 (simplified redesign, project lead).** Worst-case delay ≥ 10 s: 10.19 s at a 9 V battery with R9 −1 % (`tools/design_calc.py` `timer()`); 1.2 MΩ gave 9.46 s. Nominal about 18.4 s (sim 18.3–18.6 s). Cost: the stall limit falls to 1.61 µA (1.25 µA known sinks), so C5 + C6 insulation must be ≥ 17.3 MΩ hot (TODO BOM). Sim re-run | 2026-11-04 | 3, 6, 7 |
| **Project lead: reverse battery protected by the harness fuse only (7.5 A slow-blow inline)** | No board protection. Residual risk accepted: TVS1 and Q1's body diode put about −1 to −3.5 V on every load until the fuse opens; ISO 7637 pulse 1 has the same exposure. Supersedes the agent-assumption row above | 2026-11-04 | 2, 4 |
| **Project lead: keep SMBJ16A on BATT and ACC; assumption: the car has central load-dump suppression** | Staff review: even a centrally suppressed dump (about 35 V, up to 400 ms) exceeds the SMBJ's rating, so a dump sacrifices TVS1 (fails short) and opens the fuse; downstream parts stay below the clamp. Pulses 2a/3a/3b are within rating | 2026-11-04 | 4 |
| **Project lead: U4 = TLC555QDRQ1 (TI TLC555-Q1, automotive CMOS 555, SOIC-8)** | **Superseded 2026-11-04 (simplified redesign, project lead).** SE555 is obsolete / out of stock; NE555 and SA555 rejected for their wider threshold spec. Datasheet check (SLFS078D): NE555 pinout; VDD 2–15 V recommended, 18 V abs max; THRES 2.7–3.9 V at 5 V and 9.35–10.65 V at 15 V over the full temperature range (the SE555 limits were 25 °C only); TRIG / THRES / RESET input currents ≤ 5 nA (SE555 TRIG 0.9 µA); VOH ≥ VDD − 0.9 V at 1 mA; IDD ≤ 1 mA. The sink side of the stall limit drops from 1.25 to 1.01 µA. Needs 100 nF at VDD (C9) for its output-transition supply spikes | 2026-11-04 | 3, 6, 7 |
| **Project lead: U2 TPL7407LA replaced by three discrete N-FETs (Q2 Q1-gate pull-down, Q3 LED sink, Q4 ACC status to J5)** (Q3 superseded 2026-11-04: LED from VOUT, project lead) | **Superseded 2026-11-04 (simplified redesign, project lead).** Zero quiescent current (U2 COM drew up to 30 µA from BATT) and easy to hand solder; TPL7407LADR also showed 0 stock. Removes U2 and C10 | 2026-11-04 | 2, 4, 6, 7 |
| **Q2–Q4 = Nexperia 2N7002BK,215 (SOT-23)** (agent; Q3 later dropped) | **Superseded 2026-11-04 (simplified redesign, project lead).** 60 V V_DS (≥ 40 V needed: 33.8 V worst TVS clamp), ±20 V V_GS, V_GS(th) ≤ 2.1 V (25 °C), about 2.35 V cold (graph), gate ESD-protected to 2 kV HBM (Q4 drives the Pi cable), AEC-Q101, 318 k stocked. 2N7002K variants (Diodes, onsemi, Vishay) show 0 stock; BSS138 is 50 V with no ESD rating in its datasheet | 2026-11-04 | 4, 6 |
| **Gate dividers 0.5: R1 5.1 k → 10 k (DRV_G = Q2 + Q3 gates), R7 22 k → 47 k (STAT_G = Q4 gate); R21 1 kΩ in the J5 line** (agent) | **Superseded 2026-11-04 (simplified redesign, project lead).** The weakest drive is the 555 alone at a 9 V battery: VOH min (VDD − 0.9 V) minus a diode, halved = 3.48 V, ≥ 1.1 V above the cold V_GS(th) max (sim 3.84 V). Halving also keeps V_GS ≤ 16.5 V at the 33.8 V short-pulse ACC clamp (abs max 20 V), so no gate zeners. R1 and R7 are the gate pull-downs (gates off with the key off). C2 kept: the OR filter becomes 5 ms on / 10 ms off (was 3.4 / 5.1 ms), no delay change in the sim. Q3 shares DRV_G with Q2 (the old IN1/IN2 pairing). R21: limits ESD / wiring-fault current into Q4 from the cable; 65 mV low level at a 50 kΩ Pi pull-up. Back-feed: R7 holds Q4 off with the HAT unpowered, so the Pi pull-up sees only I_DSS (the TPL7407 had a clamp-diode path to COM) | 2026-11-04 | 2, 3, 4, 7 |
| **DZ1 SMAZ15 → 1SMA5928BT3G (13 V, 1.5 W SMA); R13 100 Ω → 220 Ω** (agent) | **Superseded 2026-11-04 (simplified redesign, project lead).** The TLC555 recommended VDD maximum is 15 V: the SMAZ15 (14.25–15.75 V) could let VDD exceed it at 16 V BATT. 13 V (12.35–13.65 V) keeps VDD inside 4.5–15 V over 9–16 V BATT and ≤ 13.9 V at the 26 V clamp (abs max 18 V). It conducts above about 12.5 V BATT; R13 220 Ω limits that continuous current to ≤ 13.6 mA at 16 V (0.17 W in DZ1). VDD at a 9 V battery is still 8.5 V. The SMAZ series has no 13 V part | 2026-11-04 | 2, 4, 6, 7 |
| **R9 1.3 MΩ and C5 = 2 × 10 µF kept with the TLC555** (agent) | **Superseded 2026-11-04 (simplified redesign, project lead).** Worst case 10.91 s at 9 V (calc; sim 11.09 s), nominal 18.3–18.7 s, stall limit 1.72 µA against 1.01 µA of sinks (C5 + C6 insulation ≥ 8.9 MΩ hot, was 17.3 MΩ). The CMOS input currents don't allow a larger R9: the LM397 output leakage (1 µA) still sinks from C5, and R9 above 2.22 MΩ stalls at 9 V even with ideal capacitors, so one 10 µF capacitor with R9 2.6 MΩ (18 s nominal) is not possible. R9 1.5 MΩ would give 12.6 s worst case but 21 s nominal and a 13 MΩ insulation requirement | 2026-11-04 | 3 |
| **Project lead: D6 = onsemi BAS116LT1G (SOT-23)** | BAV116W (SOD-123) and the SOD-123 BAS116 parts show 0 stock. Datasheet (BAS116LT1/D): I_R ≤ 5 nA at 75 V (25 °C), ≤ 80 nA at 75 V and TJ 150 °C: the same 80 nA corner the sim already used. Pinout: 1 anode, 3 cathode, 2 NC (case 318 style 8): needs a SOT-23 diode symbol (1 A, 2 NC, 3 K), not `Device:D` | 2026-11-04 | 3, 6, 7 |
| **Project lead: load dump accepted as a rare event with SMBJ16A** | A dump (even centrally suppressed) exceeds the SMBJ rating: TVS1 fails short and the harness fuse opens; downstream parts stay below the clamp. Supersedes the "assumption: central load-dump suppression" wording | 2026-11-04 | 4 |
| **Project lead: J2 (stacked USB-A) overhangs the right board edge on purpose** | Placement may move it fully onboard if space allows now that K1 is gone; otherwise the overhang must clear the Pi 5 USB / Ethernet jacks below (about 16 mm tall). The HAT standoff height is not in the SPEC: open item (TODO placement) | 2026-11-04 | 5 |
| **Timer sim: behavioural TLC555 with its datasheet threshold window in the corners; gear integration** (agent) | **Superseded 2026-11-04 (simplified redesign, project lead).** LTspice has no TLC555 model. The behavioural one uses the SLFS078D THRES limits (linear in VDD between the 5 V and 15 V rows), ≤ 5 nA input currents, RESET > TRIG > THRES priority and VOH at its minimum, so corner 1 is now the worst case directly (no hand scaling). The N-FETs are a generic VDMOS with the corner V_GS(th) (2.35 V cold max in corner 1, 0.75 V hot min in corners 3/4). Gear: the trapezoidal method rang on the high-impedance J5 node; results otherwise unchanged (≤ 0.1 ms) | 2026-11-04 | 3 |
| **Project lead: LED D3 + R3 from `VOUT` to GND; Q3 dropped** | The LED shows "Pi power on" directly, one part fewer. R3 stays 5.1 kΩ: 4.9 kΩ centres 2 mA geometrically over 9–16 V, so 5.1 kΩ gives 1.35–2.73 mA (9–16 V), 4.7 mA at the 26 V clamp. Side benefit (staff review): the LED + R3 load holds a Q1-leakage-fed `VOUT` below 1.85 V, under the TLC555's 2 V minimum supply, so a hot parked Q1 can no longer start a delay period. R1/R2/C2 stay (they are Q2's gate network) | 2026-11-04 | 2, 4, 6, 7 |
| **Project lead: HAT on standoffs above a CAN HAT; J2 overhang allowed** | The stack height puts J2's overhang above the Pi 5 USB / Ethernet jacks, so it clears them. Placement may still pull J2 onto the board if there is space. Closes the standoff-height open item | 2026-11-04 | 5 |
| **R22 10 kΩ between C5 and the TLC555 TRIG/THRES pins** (staff review) | **Superseded 2026-11-04 (simplified redesign, project lead).** The TLC555 input abs max is VDD with no +0.3 V allowance (SLFS078D 5.1). At full-load shutdown C5 dumps into the collapsing VCC through D6: up to 8.2 mA, C5 up to 1.01 V above VCC (sim with D6 at the BAS116 V_F maximum; the previous sim used a 1N4148 model and showed 0.70 V). Without R22 the CMOS input clamps share that current (latch-up risk). With R22: pins ≤ 0.57 V above VDD, ≤ 43 µA (sim; calc bound 50 µA). Timing error 50 µV. One 1206 resistor | 2026-11-04 | 3, 6, 7 |
| **Back-feed through the Pi regulator accepted, no fix** (staff review) | **Superseded 2026-11-04 (simplified redesign, project lead).** Real: a back-fed `VOUT` of 3–5 V powers U4 with C5 empty, Q goes high and DRV_G reaches 1.3–2.3 V, above the 2N7002BK V_GS(th) minimum; Q2 needs only about 15 µA to start turning Q1 on. Benign: one delay period of battery power while the Pi is powered from elsewhere (bench), no repeat. Rejected fixes: a series zener in the DRV_G path (takes the 9 V margin: the 555-only drive is 3.3 V against a 2.35 V cold threshold); a VDD lockout on RESET (would also cut VOUT during a cranking dip). J5: no back-feed path (R7 holds Q4 off; body diode reverse-biased). Bench TODO | 2026-11-04 | 2 |
| **Calc corrections (staff review)** | **Superseded 2026-11-04 (simplified redesign, project lead).** Worst-case VDD at 9 V is 8.34 V, not 8.57 V (sim value): Q1 hot at 5 A plus the 555 output current. Gives DRV_G 3.32 V from the 555 alone (cold diodes), timer worst case 10.84 s, stall limit 1.67 µA (C5 + C6 insulation ≥ 9.4 MΩ hot). DZ1 bound with no logic current: 16.1 mA, 0.20 W at 16 V (board rating 0.26 W at 85 °C, not 1.5 W, which is at T_L 75 °C); hot VDD ≤ 14.45 V. R13 pulse with the zener at its minimum: 0.85 W at 26 V, 2.1 W at 33.8 V. U3 footprint → `SOT-23-5_HandSoldering` (hand-solder rule); U4 symbol → `Timer:TLC555xD` | 2026-11-04 | 3, 4, 7 |
| **Sim: D6 = BAS116 V_F-maximum model; R22 and a generic TLC555 input clamp; LED on VOUT** (staff review) | **Superseded 2026-11-04 (simplified redesign, project lead).** The 1N4148 model under-stated D6's drop and hid the input-overdrive problem. Delays unchanged within 0.03 s (corner 1 11.09–12.28 s). The VDMOS N-FET model has no sub-threshold conduction, so the sim can't show the back-feed or leakage turn-on: those are by calc | 2026-11-04 | 3 |
| **SRP1038A footprint: 11.0 mm body side along the pad axis; courtyard 14.1 × 11.0 mm** (staff review, schematic) | Bourns "Product Dimensions" top view: the terminals sit on the ends of the 11.0 mm side, so the earlier assumption was right. The courtyard had been widened to 11.0 × 11.0 + 0.5 to cover both orientations; it is now body (10.0 mm across the pads) + 0.5 mm per SPEC 7, X set by the pads. `tools/build_lib.py` asserts the orientation | 2026-11-04 | 7 |
| **Netlist check also compares symbol pins with footprint pads (`check_pads`)** (staff review, schematic) | The netlist carries symbol pin numbers; the board connects by pad number. The SPEC 7 comparison can't see a symbol whose pin numbers don't exist on (or don't cover) the footprint's copper pads. The review found none (every part checked against its datasheet); the check keeps it that way. Selftest 15 mutations | 2026-11-04 | 7 |
| **Small-signal passives 1206 → 0805 HandSolder (31 parts); power-path and bias-critical ones stay 1206** (coordinator, overnight 2026-11-04, project lead away) | **Partly superseded 2026-11-04 (simplified redesign): the 0805/1206 rule stands; the part list is the new SPEC 5 one.** Placement at 1206 left R11/D1/D4/D5 off the board (courtyards 1387 mm² in 1810 mm² free) and no routing room. The lead's rules allow 0805 HandSolder (SPEC 5 "Parts rule"). 0805 (courtyard 3.8 × 2.0 mm against 5.0 × 2.4 mm, about 4 mm² less each): R1–R9, R11, R12, R14–R20, R22, C2–C4, C7–C9, C13, C17–C21: µA to low-mA signals; R3 dissipates ≤ 39 mW continuous at 16 V (0.11 W only during a clamp pulse); R19 sees ≤ 33.8 V (well inside 0805 working voltage); C13 works as a hot-plug divider at near-zero bias. Kept 1206: R13 (0.85 W / 2.1 W clamp pulses: no 0805 pulse-load data in hand), R21 (a 12 V wiring fault on J5 puts about 0.14 W into it), C5/C6 (timing: DC-bias and insulation margins, TODO BOM), C11, C15/C16, C22–C24 (power path, DC bias), C14 (it sets the turn-on slew while biased at BATT: DC-bias loss would raise the inrush toward the Q1 SOA), D3 (the LED part is 1206). Electrolytics C12/C25/C26 and the bottom side not needed: with the 0805s every part fits top side (`tools/post_route/03`: 43 of 64 parts at >= 0.5 mm courtyard gaps after the staff review, the rest 0.25-0.48 mm; Freerouting trial 0 unrouted with GND left to the pours) | 2026-11-04 | 5, 6, 7 |
| **Project lead: simplified redesign, about 35 parts (2026-11-04, overnight)** | **The rule stands; the LM2903B timer it produced is superseded 2026-11-05 (counter timer).** "This is too many parts… I specifically chose a [comparator] that could run at 12 V… this shouldn't be a complicated board." The design had grown to 64 parts through a cascade of reviewer fixes (SE555 18 V limit → zener clamp → TLC555 → latch-up resistor → clamp diode; TPL7407 → discrete FETs; slew caps; a second TVS; electrolytics; buck compensation). Rule from now on: a part is added only for a named, datasheet-backed failure mode, written in this table. Result: 32 parts plus J1, J2, J4, J5, SW1 (SPEC 6/7) | 2026-11-04 | all |
| **Coordinator (overnight): one dual comparator on BATT does the delay (U1A) and the ACC status (U1B); the 555, its supply clamp (R13, DZ1, C7), the LM397, the N-FET drivers, R22 and the DCL function of D6 go** | **Superseded 2026-11-05 (counter timer CD4541B, project lead; rows below).** The LM393 family runs from 2 to 36 V (38 V abs max for the B version), so it sits on `BATT` with no clamp up to the 33.8 V TVS short-pulse clamp. On `BATT` it never loses its supply when `VOUT` collapses, so the old re-latch / input-above-VDD problems (and the parts that fixed them) disappear. Open-collector outputs drive the Q1 gate and J5 directly (no N-FETs). Cost: **parked drain ≈ 0.44 mA typ, ≤ 0.81 mA bound** (SLCS005AH 5.6), ≈ 0.32 Ah/month typ: under 1 % of a 50 Ah battery per month. Accepted (coordinator; lead to confirm, TODO) | 2026-11-04 | 2, 3 |
| **U1 = LM2903BIDR (the −40 to 125 °C grade of the LM393B), not LM393DR or LM393BIDR** (agent) | **Superseded 2026-11-05 (counter timer CD4541B, project lead; rows below).** Same datasheet (SLCS005AH), pinout and limits. LM393 (non-B) is rated 0–70 °C with I_B up to 250 nA: unfit for a car and for megohm timing. LM393B is rated −40 to 85 °C (exactly the design ambient); LM2903B −40 to 125 °C with I_B ≤ 50 nA, V_IO ≤ 4 mV over temperature. Digi-Key 2026-11-04: LM2903BIDR 66.6 k stocked (LM393BIDR 46.4 k) | 2026-11-04 | 2, 6 |
| **No input dividers on U1: `C5_T` and `ACC_S` may exceed the common-mode range** (agent) | **Superseded 2026-11-05 (counter timer CD4541B, project lead; rows below).** SLCS005AH 5.6 note 1: "only one input needs to be in the valid common mode range, the other input can go up the maximum VCC level and the comparator provides a proper output state"; 7.2.2.1 case 2: IN− above the range with IN+ inside → output low (the "on" state wanted here). `REF` ≤ 0.43·BATT is always inside (VCC − 2 V hot), and at every decision point both inputs are inside. Inputs abs max 38 V independent of VCC (5.1). Saves two resistors and the loading of C5 | 2026-11-04 | 3 |
| **Timer: C5 charged from `ACC_S` (R24 + D6), discharged by R9; trip = ratiometric `REF`; R9 2.4 MΩ, C5 one 10 µF 50 V X7R 1206** (agent) | **Superseded 2026-11-05 (counter timer CD4541B, project lead; rows below).** Both ends of the decay scale with `BATT`, so 9–14.4 V changes the delay only through the diode drops and C5's DC bias (calc nominal 17.5–20.0 s). The worst-case stack (SPEC 3) gives 11.2 s calc / 11.8 s sim; R9 2.2 MΩ would give 10.3 s, too close to 10 s for a stack that rests on an assumed DC-bias curve, so 2.4 MΩ: nominal is longer than the coordinator's "about 15 s" (17.5–20 s); the 10 s floor wins, as in the lead's earlier R9 choice. A 50 V part for less DC-bias loss; one capacitor, no electrolytic (leakage). **No stall mechanism:** the only current into C5 is U1A's input bias (floor 0.12 V vs a ≥ 2.8 V trip), so a leaky C5 or D6 shortens the delay instead of keeping the Pi on until the battery is flat (the old stall limit is gone). Carried to the BOM: C5 DC-bias retention ≥ the assumed 1 − 0.04·V, insulation ≥ 100 MΩ hot | 2026-11-04 | 3 |
| **Hysteresis: R23 4.7 MΩ from `REF` to the U1A output; `REF` divider R4 1.8 MΩ / R5 1.0 MΩ** (agent) | **Superseded 2026-11-05 (counter timer CD4541B, project lead; rows below).** `REF` = 0.314·BATT while Q1 is on, 0.429·BATT while off: one clean transition; noise and buck ripple on `BATT` (≈ 0.44 V p-p × 0.31) are far inside the 1.4 V band. While U1A is off, R23's current returns to `BATT` through R15 and R14 and appears on Q1's V_GS: R23 is sized so that this stays ≤ 0.39 V at 16 V (≤ 0.64 V at the 26 V clamp) against a hot V_GS(th) ≥ 1.1 V. Rising `BATT` after turn-off raises `REF` (pushes further off): no re-latch | 2026-11-04 | 3, 4 |
| **Q1 gate: R14 220 kΩ / R15 180 kΩ straight from U1A; no slew capacitor, no gate zener, no hot-plug capacitor (C13, C14, DZ2 removed)** (agent) | **Partly superseded 2026-11-05: R14 / R15 kept (now driven by Q5); C30 100 nF G-S added for battery hot-plug (row below).** Ratio 0.55: V_GS ≥ 4.61 V at 9 V (R_DS(on) is specified at 4.5 V) and ≤ 18.8 V at the 33.8 V clamp (20 V abs max): no zener. 99 kΩ of drive on the Miller plateau ramps the drain in 0.2–0.75 ms: inrush peak 433 W calc at 16 V into the assumed 674 µF, 1.6× under the derated SOA interpolated at the ramp length (sim 267 W at 14.4 V): **the SOA doesn't demand a slew capacitor**. 100k/82k was rejected: up to 1.9 kW in the fast corner, at the SOA limit. **Battery hot-plug** couples the gate on through C_gd for < 1 ms: a `VOUT` pulse ≤ 0.54 V nominal, up to 4.2 V with Q1's threshold at its hot minimum (sim). No failure mode: nothing latches (C5 and U1 don't see `VOUT`), Q1 energy ≤ 32 mJ. Fallback if the bench shows the Pi reacting: 100 nF G-S on Q1 (one part; re-check turn-on/off times) | 2026-11-04 | 4 |
| **R24 1 kΩ in the C5 charge path** (agent) | **Superseded 2026-11-05 (counter timer CD4541B, project lead; rows below).** Named failure modes: SW1's switching rating is 24 V / 25 mA (Nidec CAS catalogue) and BAS116's forward rating is 200 mA (500 mA surge); charging 10 µF straight from `ACC_S` would take amps. With R24: ≤ 15.9 mA through SW1 at 16 V, ≤ 25 mA in D6 at the 26 V ACC clamp. τ ≈ 8 ms keeps key-on fast and a 50 ms blip at a full charge | 2026-11-04 | 3 |
| **TVS2 kept on ACC_IN** (agent; the brief asked to evaluate) | **Reason updated 2026-11-05: U1 is gone; TVS2 now keeps pulse 2a off the Q5 / Q6 gates (20 V abs max, `ACC_G` = 0.55 × `ACC_S`) and pulse 1 off D5.** Without it, ISO 7637-2 pulse 2a (≤ 112 V, 2 Ω, 50 µs) reaches U1B IN− through D5 (input abs max 38 V; R8 47 kΩ is the only load), and pulse 1 (−150 V) exceeds D5's 100 V reverse rating. R24 already protects C5/D6. One part covers both failure modes | 2026-11-04 | 4 |
| **R8 47 kΩ pull-down on `ACC_S`; SW1 straight to `ACC_S` (D4 removed); D5 kept** (agent) | **Partly superseded 2026-11-05: R8 is now the 22 kΩ top of the `ACC_G` divider (R25 the bottom, also the pull-down); D5 and the D4 restore stand.** **D4 part superseded 2026-11-05 (schematic staff review: D4 restored, row below).** U1B's input bias flows out of IN− (PNP input): an open key switch would let `ACC_S` float up and read "ACC on". 47 kΩ also holds a leaky "off" ACC line low (10 µA → 0.47 V, assumption about car wiring). D4 had no job: SW1 only ever connects `BATT` to `ACC_S`. D5 stays: it keeps `BATT` (through SW1) off the car's ACC line | 2026-11-04 | 2 |
| **R21 1 kΩ → 1.5 kΩ (1206)** (agent) | J5 wired to 16 V by mistake: 1 kΩ dissipates 0.26 W (over a 1206's 0.25 W); 1.5 kΩ: 0.17 W and 10.7 mA into U1B (abs max 25 mA). ACC-on level at a 50 kΩ Pi pull-up: 0.1 V + VOL | 2026-11-04 | 2 |
| **No bulk capacitors: C11 (BATT), C12 (VOUT electrolytic), C25/C26 (USB electrolytics) removed** (agent) | No named failure mode needs them. `BATT`: U1 has C8; Q1 ties `BATT` to `VOUT` while on and TVS1 clamps a harness ring on both. `VOUT`: the buck has C15/C17, the Pi regulator its own input capacitors. USB: the buck loop without them is stable (PM ≥ 52°, fc 16–42 kHz) and the 3 × 47 µF ceramics next to J2 are the output capacitance; a phone plugging in (≤ 10 µF, USB device limit) steps VBUS by ≤ 1.1 V for microseconds (charge sharing). The USB 120 µF per-port figure is a host-port droop rule for data ports, not needed for a charge-only port **(assumption: bench with a phone)** | 2026-11-04 | 4 |
| **Coordinator (overnight): buck stays TPS54336A; TPS54302 rejected on thermal** | TPS54302 (SOT-23-6, no exposed pad: SLVSDG6C) would save 2–3 parts, but at 3 A (fig. 7-2: ≈ 92.5 % at 12 V) its IC loss is ≈ 1.2 W at an 85 °C ambient: TJ ≈ 152 °C with the EVM RθJA 57.2 °C/W, 224 °C with the JEDEC 118.9 °C/W; 2.4 A: 132 / 182 °C. Recommended TJ maximum 125 °C, shutdown 160 °C. TPS54336A (PowerPAD, RθJA 42.1 °C/W): ≈ 128 °C typ at 3 A / 85 °C (150 °C rated). Lead option (TODO): TPS54302 if a lower USB current or ambient is acceptable | 2026-11-04 | 4 |
| **Buck simplified: one input capacitor (C16 removed), Type 2B compensation (C21 removed), EN floating (R19/R20 removed)** (agent) | C16: the TI example uses one 10 µF + 100 nF (SLVSCD5D 8.2.2.5); 1.5 A rms is within one 10 µF X7R; ripple ≈ 0.44 V p-p. C21: an optional high-frequency pole (Type 2A vs 2B, 7.3.17); without it and without the USB bulk the loop keeps PM ≥ 52°. R19/R20: "float the EN pin to enable" (pin table, 7.3.5); the internal VIN UVLO (4.0–4.5 V) is enough: below the old 7.1 V start the USB ports just run in dropout, nothing is harmed. C19 (SS) kept: without it the start-up charges the output at the current limit | 2026-11-04 | 4, 7 |
| **Sim: behavioural LM2903B; nonlinear C5; constant-power load with a harness** (agent) | **Superseded 2026-11-05 (counter timer CD4541B, project lead; rows below).** LTspice has no LM393/LM2903 model (`lib/sub` checked). Corners as SPEC 3; LOAD 1 has the Pi shut down 3 s into the delay so that `BATT` rises mid-delay (re-latch check). `reports/sim_delay_off_lm393.md` | 2026-11-04 | 3 |
| **Staff review of the simplified redesign: no part added or removed, no value changed (32 parts)** (staff review) | **Partly superseded 2026-11-05 (counter timer).** Re-checked against the PDFs: SPEC 7 pins (LM2903 symbol 1/2/3, 5/6/7, 4/8 = SLCS005AH fig. 4-1; TO-252-2 pad 2 = tab = drain, SQD50P04 top view G-D-S; BAS21 1 A / 2 NC / 3 K = BAS116 case 318 style 8; TPS54336A DDA 1 BOOT … 8 SS; CAS-120A pad 2 common); J1, J2, J4, J5, SW1 footprints and pin order identical to the 231351 SPEC (SW1 pin 1 net renamed only). Every part has a datasheet-backed job; nothing can go. Logic scenarios traced: key on/off, restart, blip, SW1, hot-plug, back-feed, no re-latch: as SPEC 3 | 2026-11-04 | all |
| **Timer short stack adds 5 % C5 aging; C5 insulation requirement relaxed from 100 MΩ to ≥ 25 MΩ hot** (staff review) | **Superseded 2026-11-05 (45 s timer: 10 % aging from the GMC datasheet, insulation as Ω·F).** Class II (X7R) capacitance falls with time after the last heat; the tolerance alone doesn't cover the service life (**assumption** 5 %: no C5 datasheet in `ref/`). Short stack 11.7 → 11.1 s calc (10.7 s at 14.4 V), sim corner 1 11.8 → 11.2 s: still ≥ 10 s, so R9 stays 2.4 MΩ (raising it would push the nominal further from the lead's 15 s). The old 100 MΩ figure was a stack input, not a limit: `timer()` now finds the insulation at which the short stack reaches 10 s (17–25 MΩ), which is the real requirement. MLCC insulation is specified as an Ω·F product, so a 10 µF part's guaranteed value may be lower: BOM/bench item. The stack also combines cold diode drops with hot leakage limits, so it is pessimistic | 2026-11-04 | 3 |
| **Buck loop: datasheet error-amplifier model (Roea 3.07 MΩ, Coea 20.7 pF) replaces the assumed 10 MΩ** (staff review) | SLVSCD5D 7.3.15 gives both values; `reports/buck_design.md` said the datasheet gave neither. Coea also acts as a small high-frequency pole without C21. Result: PM ≥ 51° (was 52°), fc 16–42 kHz unchanged: Type 2B without C21 stays | 2026-11-04 | 4 |
| **Q1: no change for cranking or inrush; SPEC numbers completed** (staff review) | The SPEC quoted only the Qgd-typ inrush rows; `design_calc.py` also bounds half Qgd: 108 A / 866 W at a 0.1 ms ramp (16 V) against the 1.2 kW derated 100 µs SOA line (1.4×), I_DM 200 A: still no slew capacitor. 33.8 V is the TVS 8/20 µs clamp, too short for the 0.3 ms gate network, so 14.4 V at 26 V is the binding V_GS: consistent. Raising the gate ratio would help a 6 V crank (V_GS 3.3 V, Q1 may current-limit) but costs the load-dump margin, and below 9 V is outside the operating range: kept | 2026-11-04 | 4 |
| **TVS2, R21, R24 confirmed needed** (staff review) | **Partly superseded 2026-11-05: R24 removed with C5; TVS2 and R21 stand (R21 now protects Q6).** TVS2: U1B IN− abs max 38 V (SLCS005AH 5.1) and D5 V_RRM 100 V (1N4148W) vs ISO 7637-2 pulses 2a / 1 on the ACC line. R21: J4/J5 are the same block next to each other; 12–16 V on J5 would drive U1B past its 25 mA output rating ("short circuits from outputs to VCC can cause … destruction", 5.1 note 4); 10.7 mA at 16 V with R21. R24: CAS-120 switching rating 24 V / 25 mA (Nidec), 15.9 mA at 16 V | 2026-11-04 | 2, 4 |
| **Schematic redrawn for the simplified SPEC 7 on A4** (agent) | `tools/post_sch/03_simplified.py`: 32 parts plus J1/J2/J4/J5/SW1 fit an A4 sheet legibly in eight blocks (input / ACC sense, reference, delay timer, comparator, P-FET switch, status / LED / Pi 12 V, buck 5.1 V, USB); the old A3 was for ~70 parts. Surviving parts keep their symbol uuids, so the board update can match footprints. PWR_FLAGs only on nets fed through passives or connectors (BATT, GND, VOUT, +5V1) | 2026-11-05 | 7 |
| **D4 (1N4148W) restored in series with SW1: `BATT` → SW1 → `SW1_C` → D4 → `ACC_S`** (schematic staff review) | "SW1 only ever connects `BATT` to `ACC_S`" holds only while `BATT` is alive. SW1 closed with `BATT` dead (harness fuse blown, or a bench supply on ACC only): ACC → D5 → `ACC_S` → SW1 → `BATT`, and Q1 (held on by C5) passes the whole 3.5–5 A load through D5 (1N4148W I_F 300 mA, I_FSM 500 mA < 1 s: Vishay) and SW1 (100 mA non-switching: Nidec CAS). D4 blocks it; same part as D5 (no new BOM line); in SW1 mode `ACC_S` = `BATT` − V_F, the same as a key-on. SW1 sim re-run with D4: delay 11.2–26.9 s (≥ 10 s). Alternatives rejected: SW1 into `D6_A` (R24 limits the fault, but SW1 would no longer pull J5 low: SPEC 2 "SW1 acts like the key"); a resistor instead of D4 (also one part, dissipates in the fault). 33 parts. Lead may revert (TODO) | 2026-11-05 | 2, 6, 7 |
| **J1, J4, J5 rotated 180° in place at placement; hand-assembly spacing rule** (project lead) | The lead accepted that the terminals' wire entries face into the board (J4 into J1's body: no room for a wire) and wants the board model corrected: each is turned 180° about its own position, so the wire entries face outward and the pin order along the row follows the rotation (nets move with the pads). Placement rule: hand assembly, nothing smaller than 0805, parts spaced out where possible | 2026-11-05 | 5 |
| **U1 power unit drawn as a boxed block: project symbol `pipwr:LM2903`** (project lead) | **Superseded 2026-11-05 (counter timer CD4541B, project lead; rows below).** The lead: "U1 is fine as 3 units, but V+ and GND are bare floating pins". KiCad 10 has no LM2903 (or other dual comparator) whose power unit has a body, so `lib/pi_power_board.kicad_sym` holds a copy of `Comparator:LM2903` with a rectangle on unit C (pins 4 GND, 8 V+ per SLCS005AH table 4-1; units A/B and all pin numbers stock). U1 keeps its symbol and pin uuids (board link). C8 sits next to it on the same `BATT` / GND wires. `tools/post_sch/05` | 2026-11-05 | 7 |
| **Schematic staff review: no other change** (schematic staff review) | Re-checked on the drawn sheet: symbol pin = footprint pad = datasheet pin for U1 (SLCS005AH fig. 4-1, SOIC-8, 3 units), Q1 (TO-252-2 pad 2 = tab = D; SQD50P04 G-D-S), D6 (BAS116 case 318 style 8), U8 (SLVSCD5D pin table, pad 9 GND), SW1 (CAS-120A1 drawing: ② = C, the common, alone on one side = pad 2), TVS/diode/LED cathodes on the positive side, J2 per-row VBUS/D±/GND, J1/J4/J5 pads against the lead's board silk (GND/ACC/BATT, 12V/GND, GND/ACC_N). ERC rules equal the KiCad 10 template defaults, no exclusions; PWR_FLAGs on BATT (J1), GND, VOUT (Q1 drain), +5V1 (L1): all fed only by passive pins. Surviving symbol uuids kept (34). check_netlist selftest: U1/D4-specific mutations added (inputs swapped, power unit missing, 14-pin package, D4 reversed) | 2026-11-05 | 7 |
| **Delay-off hold ≥ 45 s worst case after the last key-off** (project lead) | **The target stands; "topology kept" is superseded 2026-11-05 (counter timer).** On a rapid key cycle (key on for a moment, then off) the Pi 5 cold-boots with ACC already off: it must finish booting, see `ACC_N` released and shut down cleanly before `VOUT` drops. The old ≥ 10 s target only covered a running Pi. Topology kept (U1A RC threshold with hysteresis, U1B ACC status); passives tuned. Hand-assembly rule: nothing smaller than 0805. The Pi software must check the `ACC_N` level at boot, not only edges (SPEC 2, TODO) | 2026-11-05 | 2, 3 |
| **Timer resized for 45 s: C5 + C27 + C28 = 3 × 10 µF 50 V X7R 1206 (Cal-Chip GMC31X7R106K50NT), R9 2.4 → 4.7 MΩ; R4 / R5 / R23, R24 unchanged** (agent) | **Superseded 2026-11-05 (counter timer CD4541B, project lead; rows below).** Short stack (`design_calc.py` `timer()`) with 10 % aging (GMC: < 2 %/decade, 5 decades): 52.4 s calc, 55.1 s sim; nominal 103–121 s, long ≤ 167 s (a long hold only keeps a halted Pi powered longer). Options for ≥ 45 s with margin, all with the same insulation need: 2 × 10 µF + 7.5 MΩ (1 part, R9 3×), **3 × 10 µF + 4.7 MΩ (2 parts)**, 4 × + 3.6 MΩ (3), 5 × + 3.0 MΩ (4). Chosen: R9 stays within 2× of its old value (D6 leakage and the IN− bias stay small against R9's current: stall floor 0.24 V vs trip ≥ 2.78 V) and equals R23 (no new BOM value). **Insulation sets the margin, not the split:** X7R insulation is specified in Ω·F, so the parallel network has the same Ω·F as one part; the short stack needs ≥ 417 Ω·F (≥ 13.9 MΩ for the node, board included). GMC states 1000 Ω·F at 25 and 125 °C; Samsung CL31B106KBHNNNE only 100 Ω·F at 25 °C (25 Ω·F after life test), which can't reach 45 s with any R9: GMC chosen for that (stocked, 140 k). No 22 µF 50 V X7R 1206/1210 in stock (TDK C3225X7R1H226M250AC: ±20 %, 0 stock), so 1206 parts stay. Key-on recharge: currents unchanged (≤ 15.9 mA at 16 V, SW1 25 mA); τ 21–25 ms; ≥ 34 ms of key-on from an empty C5 gives ≥ 45 s (sim: 40 ms blip ≥ 51.5 s). Reference / hysteresis not touched: a lower trip ratio would lower the insulation need but changes the U1B ACC threshold and every Q1 / REF figure. Refs C27 / C28: unused on the old board (C6 / C7 still exist there) **(assumption)**. `tools/post_sch/06` | 2026-11-05 | 3, 6, 7 |
| **Project lead: clock + counter delay-off timer powered from `+5V1`; no separate LDO; no Pi HOLD line (J5 stays 2-pin)** | A pure RC delay can't guarantee a long hold with ordinary X7R capacitors: a capacitor's insulation (Ω·F) is its own self-discharge τ, about 10 s hot. The lead wants ≥ 45 s worst case so that a Pi 5 cold-booted by a rapid key cycle can see ACC off and shut down. ACC (or SW1) turns Q1 on directly; the timer on `+5V1` holds Q1 after ACC drops and lets go at the end of its count, collapsing `VOUT` and `+5V1` (its own supply too: intended). Key-on during the count restarts the full delay. No LDO: `+5V1` also feeds phones and the Pi's screen (3 A); a USB brownout that cuts the Pi early is acceptable (overlay filesystem): noted, not designed around. "Don't just go with the first chip you find": survey `reports/timer_survey.md` | 2026-11-05 | 2, 3 |
| **U5 = CD4541BM96 (TI) programmable timer, not 74HC4060, CD4536B, LTC6993/6994/6995, TPL5110/5111, 74HC4040 or an ATtiny402** (agent, survey) | `reports/timer_survey.md`. One SOIC-14 has the oscillator, a 2^15-count transition at a C0G-friendly 468 Hz, Q̅ polarity, a latched single transition, a level MR and a power-on reset: 5 core parts (74HC4060 needs a stop diode and an inverter: 7). Hard rejections: LTC6994 / LTC6993 max 33.6 s (ADI LTspice model at RSET 800 kΩ, DIVCODE 7); TPL5110/5111 ignore a manual re-trigger while DRV is active (SNAS650A 7.3.1, 7.5.2: no restart); LTC6995-1 does the function (ADI model) but has 0 stock in all grades and costs ~$5; CD4536B has more parts, a wide SOIC and a scanned PDF. ATtiny402 (3 parts fewer, ±5 %) rejected for firmware + a UPDI flashing step on a two-board hobby build. CD4541B: −55 to 125 °C, 3–18 V (20 V abs max), $0.51 at 10, 7972 stocked; MC14541BDR2G second source (onsemi PDF blocked: pinout assumption) | 2026-11-05 | 3, 6 |
| **U5 set-up: A = B = 1 (2^16 tap, output after 32 768 counts), Q/Q̅ = 1, MODE = 0, AR = 0 (auto reset on); RTC 42.2 kΩ, CTC 22 nF C0G, RS 84.5 kΩ: 70.0 s nominal, 56.5 s worst short, 85.7 s long** (agent) | The 2^16 tap is the only one reaching ≥ 45 s at a frequency where RTC stays far above the 370 Ω driver resistance and RS's 1 µA input current is negligible; 468 Hz is below the formula's stated 1–100 kHz (bench calibration TODO). C0G removes DC bias, aging and insulation from the stack. The stack's k = 2.0–2.6 is an assumption (no oscillator tolerance in SCHS085E) that covers the gate-level sim's 2.27–2.42. **AR on:** every power-up becomes a bounded hold (output high, then a full count); with AR off "counting will not start until after a positive MASTER RESET pulse", so a brownout or glitch power-up with ACC off could leave the output high and Q1 on until the next drive. Risk kept: the auto reset's behaviour on a slowly falling VDD is not described (bench) | 2026-11-05 | 3 |
| **ACC interface: R8 22 kΩ / R25 27 kΩ to `ACC_G`; Q6 2N7002BK for J5; D6 + R29 47 kΩ OR into one hold FET Q5; R26 100 kΩ into MR** (agent) | `ACC_G` ≥ 4.52 V at 9 V (cold diode) for MR's VIH and the FET gates, ≤ 18.4 V at the 33.8 V clamp (V_GS 20 V); the 49 kΩ divider replaces the old R8 pull-down. **R26 and R29:** with `+5V1` still at 0 V (first ms after key-on) the U5 MR and OUT protection diodes would pin `ACC_G` and `HOLD_G` one diode above 0 V and Q1 might never start; through 100 k / 47 k, `HOLD_G` ≥ 2.79 V at 9 V cold (2N7002BK cold max 2.35 V). **One FET on `DRV`:** Q5 I_DSS bound at 85 °C (3.0 µA, log-interpolated from 1 µA / 25 °C and 10 µA / 150 °C) × R14 = 0.66 V against Q1's 1.26 V threshold; two parallel FETs (ACC and timer) would give 1.33 V. D6 (BAS116, ≤ 80 nA hot) keeps its ref and footprint. Q6 replaces U1B for J5 | 2026-11-05 | 2, 3 |
| **C30 100 nF Q1 gate-source capacitor added** (agent; named failure mode) | Sim, first run without it: a battery hot-plug with the key off at 16 V and Q1 at its hot threshold turned Q1 on through C_gd; `VOUT` passed U8's UVLO, `+5V1` came up and U5's auto reset started a full hold with the key off (12 V: a 4.3 V `VOUT` pulse, just under the 4.5 V UVLO). In the old design nothing on `VOUT` could latch; now `+5V1` powers the timer, so the pulse matters. C30 holds V_GS ≤ 0.34 V at 16 V (sim: `VOUT` ≤ 0.5 mV in every corner). It adds a ≈ 7 ms turn-on and ≈ 28 ms turn-off delay but no current on the Miller plateau, so ramp, inrush and SOA are unchanged (sim inrush peak 33–127 W). Same part as C8 / C17 (no new BOM line). Supersedes "no hot-plug capacitor" (2026-11-04) | 2026-11-05 | 4 |
| **Removed with the RC timer: U1, R4, R5, R9, R23, R24, C5, C27, C28; parts 35 → 36** (agent) | Nothing on `BATT` needs a comparator any more: the delay is U5's count and the ACC status is Q6. Kept with new nets: R8, D6, C8 (survivor refs and footprints for the board update). New: U5, Q5, Q6, R25–R29, C29, C30. Parked drain from `BATT` falls from ≈ 0.44 mA to ≤ 3 µA (bounds) | 2026-11-05 | 6, 7 |
| **Sim: system at real time with a behavioural integrating counter; U5 oscillator and counter checked gate by gate (`ltspice/cd4541_osc_counter.cir`, ×1000 for the counter)** (agent) | No CD4541B model exists in LTspice. Simulating 32 768 real clocks in every one of 27 system steps would be slow; the counter's logic (reset, count, single transition, restart) is checked once at a scaled frequency, its period constant at real values. Report `reports/sim_delay_off_counter.md` | 2026-11-05 | 3 |
| **Hold target ≥ 25 s worst case (was ≥ 45 s), nominal ≈ 30 s; the oscillator's short-delay corner inside the datasheet formula range** (project lead) | Now that a counter sets the delay, 25 s is enough for a cold Pi 5 boot to detect ACC off. The lead questioned running U5 below the formula's stated 1 kHz floor (A11: 468 Hz) | 2026-11-05 | 3 |
| **R27 39.2 kΩ, C29 10 nF C0G ±1 % (KEMET C0805C103F5GACTU), R28 78.7 kΩ; tap 2^16 kept: 26.2 / 29.5 / 32.5 s, 1253 / 1109 / 1008 Hz** (staff review A12) | The short corner sets the guarantee, and ≥ 25 s caps its frequency at 32 768 / 25 s = 1.31 kHz: 1.25 kHz is near that cap and 25 % above the 1 kHz floor. The 2^16 tap is the longest; a shorter tap needs a lower frequency. **±1 % C0G** (value change, no part): ±5 % gives a 25.1 s short corner (no margin) and 970 Hz long; ±2 % gives 25.9 s and 998 Hz. Only ±1 % keeps the long corner ≥ 1 kHz too (by 0.8 %). 39.2 kΩ balances the driver-resistance error (∝ 1/RTC) against the RS input-current error (∝ RTC); RS = 2.01·RTC (datasheet ≈ 2·RTC, ≥ 10 kΩ). In stock (21 764, $2.60 at 10) | 2026-11-05 | 3, 6, 7 |
| **Oscillator constant bound 2.105–2.449 derived from the datasheet structure, not assumed (A11: 2.0–2.6)** (staff review A12) | The datasheet gives 2.3 with no tolerance. `design_calc.py` `_osc_k()` solves fig. 2 (one input threshold, RTC driven inverted, CTC in phase, RS to the pin) over the datasheet limits: threshold 0.3–0.7·VDD, VDD 4.5–5.5 V, RS-pin diodes, ±1 µA input current, 0–370 Ω drivers. A 0–1 µs gate delay is assumed. Result 2.148–2.401, plus ±2 % for the LTspice gate model, which reads up to 2 % lower, and silicon beyond fig. 2. A11's 2.0–2.6 was wider than the datasheet supports; with it, a 25–32.8 s window (1.31× spread) could not be met | 2026-11-05 | 3 |
| **Oscillator sim model corrected: CTC stage fed from the internal node, buffered gate delay, CASE step (driver R, input current, diode)** (staff review A12) | With an RS-pin input current, A11's model (CTC stage driven from the RTC pin) parked on its DC point (no oscillation): an artefact. In fig. 2 both pin drivers hang off the internal chain | 2026-11-05 | 3 |
| **C30 100 nF kept: the hot-plug mechanism is real; 100 nF is the minimal one-part fix** (staff review A12) | Datasheet: Crss 352–440 pF at 25 V (larger near 0 V), Ciss ≤ 3.95 nF. Without C30 a battery step couples −VB·Cgd / (Cgs + Cgd) onto V_GS: ≥ 1.8 V at 16 V even with the 25 V Crss, above V_GS(th) min 1.5 V. R14 can't act on a µs edge. Holding ≤ 0.55 V at 16 V and < 1.1 V (hot threshold) at the 26 V clamp needs ≥ 67 nF; 100 nF keeps margin. Cost: turn-off linear region ≤ 19 ms (calc), sim 15 ms / 105 mJ / 20.5 W, inside the derated SOA | 2026-11-05 | 4 |
| **Finding, not fixed: a persistent USB overload during the key-off count can keep Q1 on (U8 hiccup → U5 auto reset → restart, repeated)** (staff review A12; lead decision in TODO) | **Superseded 2026-11-05 (U5 from `VOUT`, project lead; next rows).** A11's "one longer hold, bounded" is true only for a single dip. TPS54336A hiccup (16 384 cycles off, retry: SLVSCD5D 7.3.13) re-powers U5 every 40–60 ms, and the CD4541B auto reset restarts the count on every power-up (p. 1). Sim OVL run (U8 current limit and hiccup added): `VOUT` still on after the normal end in 9 of 18 steps. The fix needs a part (D7 + bulk C8 hold-up, or a `VOUT`-fed U5 supply against the lead's ruling), so it waits for the lead; no part added | 2026-11-05 | 2 |
| **D7 BAT43W from `+5V1` to a new `VDD_TMR` (U5 VDD, A, B, Q/Q̅ SELECT), C8 100 nF → 10 µF 50 V X7R 1206; parts 36 → 37** (project lead) | **Superseded 2026-11-05 (U5 from `VOUT`, project lead; next rows).** A persistent USB overload makes U8 hiccup; each retry re-powered U5 and its auto reset restarted the count (staff review A12). D7 + C8 keep U5 up through one off time (65.6 ms: 5.4 µF effective vs 4.7 µF needed at the typical 131 µA; the datasheet maxima would need 36 µF). A, B and Q/Q̅ SELECT move with VDD to `VDD_TMR`: the MR clamp current can lift `VDD_TMR` above `+5V1` while ACC is on (≤ 8.0 V at 16 V), and inputs tied to `+5V1` would then sit below VIH | 2026-11-05 | 2, 3, 4, 6, 7 |
| **D7 = BAT43W-E3-08 (Vishay Schottky, SOD-123), not the BAS116 / 1N4148W already on the board** (agent) | **Superseded 2026-11-05 (U5 from `VOUT`, project lead; next rows).** Lowest drop at µA–mA (V_F ≤ 0.33 V at 2 mA vs 0.6–0.9 V), so `VDD_TMR` ≥ 4.07 V keeps the MR, VIL and `HOLD_G` (≥ 3.56 V vs 2.35 V cold) margins; 56 k in stock. Cost: I_R ≤ 100 µA at 100 °C (a bound), counted in the C8 sizing | 2026-11-05 | 3, 6 |
| **Finding, not fixed by D7 + C8: a hard USB overload still keeps Q1 on with the key off** (agent; lead decision in TODO) | **Superseded 2026-11-05 (U5 from `VOUT`, project lead; next rows).** C8 recharges only when a retry lifts `+5V1` above `VDD_TMR` + V_F. At 0.5 Ω the retry peaks near 2.4 V: U5 sits at 1–2.5 V, below its 3 V minimum, count frozen and output high (model assumption), and `HOLD_G` keeps Q5 on. Sim OVL: 17 of 18 steps stuck (9 of 18 before D7); the soft band (0.8–1.0 Ω) now ends in 5 of 6 steps at the typical U5 current (2 of 6 before) | 2026-11-05 | 2, 3 |
| **U5 powered from `VOUT` through a series resistor and a zener clamp, not from `+5V1` through D7 BAT43W + C8 10 µF** (project lead) | The overload sim showed D7 + C8 fails on a hard USB short (0.5 Ω): U8's hiccup retries reach only ≈ 2.4 V, U5 sits below its 3 V minimum with its output high, and Q5 holds Q1 on with the key off (17 of 18 OVL steps). `VOUT` exists only while Q1 is on, so U5 is unpowered when parked (drain unchanged) and no `+5V1` fault reaches it. Sim after the change: the hold ends on time in every overload step (SPEC 2) | 2026-11-05 | 2, 3, 4, 6, 7 |
| **D7 = BZT52C5V1-E3-08 (5.1 V zener, SOD-123), R30 1.3 kΩ 1 % 1206, R31 10 kΩ bleed, C8 1 µF 50 V X7R 0805; parts 37 → 39; R27 / C29 / R28 unchanged** (agent A13) | **Zener 5.1 V, VDD_TMR clamped (4.45–5.71 V), not following `VOUT`:** the MR divider gives `ACC_G` ≥ 4.42 V at 9 V and can't rise (FET gates 18.4 V at the 33.8 V clamp), so VIH = 0.7·VDD needs VDD ≤ 6.3 V; 5.1 V is also where SCHS085E tabulates the thresholds, and a clamped VDD keeps the timing off the battery voltage (no frequency-vs-VDD curve in the datasheet). The k bound over 4.45–5.71 V is 2.104–2.450 (was 2.105–2.449 over 4.5–5.5 V): delay 26.1 / 29.5 / 32.5 s, no re-tune. **R30 1.3 kΩ:** zener ≥ 1 mA (its knee test point) at `VOUT` 8.58 V with U5 at its datasheet maxima (0.54 mA) and R31; 98 mW at 16 V (1206: 205 mW at 85 °C), 0.35 W during the 26 V clamp pulse (pulse curve: BOM). **R31 (beyond the brief):** Q1 I_DSS (≤ 10.5 µA at 85 °C, 50 µA at 125 °C) lifts a parked `VOUT` to the LED knee with nothing else sinking it, where U5 could wake with its output high and turn Q1 on through Q5; R31 holds `VDD_TMR` ≤ 0.10 V (0.50 V at 125 °C). Dropping it saves one part at that risk (lead item, TODO). **C8 1 µF:** decoupling only; R30·C8 1.3 ms filters the 8/20 µs peak. Power while on: 67 mW at 12 V, 139 mW at 16 V | 2026-11-05 | 2, 3, 4, 6, 7 |
| **Schematic: `tools/post_sch/09_u5_vout_supply.py`; D7 keeps its ref and symbol uuid as the zener (`Device:D_Zener`)** (agent A13) | Same function (U5 supply diode), same SOD-123 footprint, so the board link stays. R30 / R31 are unused refs. The supply is drawn as one block on U5's VDD rail (project lead: no bare power pins) | 2026-11-05 | 7 |
| **C22–C24: 47 µF 10 V X7R 1210 (Cal-Chip GMC32X7R476K10NT), was X5R 1206** (project lead: X7R; agent: 1210) | X5R is rated to 85 °C next to U8 / L1. Digi-Key lists no 47 µF 10 V X7R 1206 (2026-11-05 keyword search); one 1210 per position keeps the part count and the loop analysis (≥ 12 µF effective each: BOM verifies the DC bias). C_1210 HandSolder footprint | 2026-11-05 | 4, 5, 6, 7 |
| **Schematic redrawn for the counter timer by `tools/post_sch/08_cd4541_timer.py`; `Timer:CD4541BM` stock symbol kept** (agent) | ERC accepts RTC / CTC typed as inputs (their nets carry passive pins only): 0 errors / 0 warnings, so no project-library copy. 07 never ran (the sheet was the 06 result); 08 removes C28 too. The 31 surviving parts keep their symbol uuids | 2026-11-05 | 7 |
| **R31 10 kΩ bleed kept** (staff review of 08 / 09, 2026-11-05; lead's question: is the LED + R3 enough?) | Without R31 the only fixed sink on a parked `VOUT` is D3 + R3, which carries no current below the LED knee. Q1 I_DSS (SQD50P04-13L: ≤ 1 µA at 25 °C, ≤ 50 µA at 125 °C, 40 V; ≈ 10 µA at 85 °C log-interpolated) then lifts `VOUT` and `VDD_TMR` to about the knee at microamps (≈ 1.4–1.6 V, **assumption**: the LiteOn datasheet gives V_F only at 20 mA, 2.0 V typ). That is above the 2N7002BK hot threshold (0.75 V at 125 °C), and Q5 only has to sink ≈ 6 µA (Q1 V_GS(th) min ÷ R14) to start turning Q1 on: if U5's output sits high at that VDD (CD4541B operates from 3 V; nothing is specified below), the loop is positive feedback and latches a full hold. R31 holds `VDD_TMR` ≤ 0.10 V at 85 °C, 0.50 V at 125 °C. U8's VIN current below its UVLO and the Pi regulator on J4 are not specified sinks, so they can't replace R31 | 2026-11-05 | 2, 3 |
| **Schematic: `tools/post_sch/10_u5_value_field.py` (U5 Value field below the body)** (staff review) | The 09 sheet had "CD4541BM96" under C8's value, between the C8 and D7 ground symbols: it read as C8's part number. Position only; no part, net or uuid changes. R30's position (at the right end of the rail, under the P-FET header) kept: the rail is full at value-text spacing and every other place collides with a wire or note | 2026-11-05 | 7 |
| **Placement (2026-11-05, `tools/post_route/06_placement.py`): Q1 pins-up in the J4 corner, C30/R14 straddling G-S, TVS1 on the BATT run next to J1, TVS2 + D5 outside the power loop; buck along the top (TI layout guide); SW1 at the left edge** (agent A15) | **Power loop:** J1 BATT (top pin after the rotation) -> Q1 -> VOUT -> J4 pin 1 encloses J1's ACC pin whatever the placement, so one net must cross on the bottom: ACC_IN leaves J1 pin 2 (THT) on the bottom. Q1 in the J4 corner gives a ~4 mm VOUT strip to J4 and a ~20 mm BATT L (3 mm), the shortest 5 A path found (Q1 under J2 or tab-left both needed ~40 mm of 3 mm VOUT). C30 needs G-S (hot-plug: DECISIONS C30 row), so the corner holds Q1, C30, R14 and one TVS: TVS1 (BATT, the energy path, ~8 mm from J1) won; TVS2 (~27 mm of ACC_IN; ~25 nH, negligible against µs pulses) sits by D5. **Buck:** SLVSCD5D 10.1 / fig. 55 rotated onto the J2 side: power pins toward J2, C17 then C15 at VIN/GND, PH by vias (pin 3 sits between VIN and GND), L1 below the output caps, C22-C24 along the top GND rail with +5V1 down to the J2 VBUS pins (C24 nearest J2), analog parts below-left of U8. **Gaps:** 27 of 44 parts >= 1.0 mm courtyard-to-courtyard; the hand-placed power corner and buck row 0.53-0.81 mm (Cin at the pins, a full top band between J5 and J2); J1-J4 0.30 mm (the lead's positions). **SW1** at the left edge: the only edge free of connectors (J2/J1/J4 right, GPIO header top, Waveshare IO bottom) | 2026-11-05 | 2, 5 |
| **J1, J4, J5 rotated 180 deg about their pad rows (`tools/post_route/05_sync_cd4541.py`); fixed baseline updated by the recorded `check_fixed.py --accept-lead-change J1,J4,J5`** (project lead decision, implemented by agent A15) | Wire entries (footprint local +y: Phoenix 1727010 drawing, pins 3.6 mm from the wire face) now face outward: J1 +x (BACK HEADER strip, board edge), J4 +y (Waveshare notch), J5 -y (GPIO notch). Same pad locations, pin order reversed (nets follow pins): J1 BATT/ACC/GND top to bottom, J4 12V/GND left to right, J5 ACC_N/GND left to right; silk pin labels re-made. No body overhangs the outline (F.Fab check). The baseline generator still refuses to overwrite; the only change path is a named, guarded lead change recorded in the JSON | 2026-11-05 | 5 |
| **Placement staff review (2026-11-05, `tools/post_route/07_placement_review.py`): 06 kept except D4 Path re-linked, R30 / D4 / R3 turned 180 deg, C18 0.5 mm down** (staff review A16) | **Checked against the sources, no change:** every footprint's value, footprint and pad nets = snapshot; J1/J4/J5 wire faces outward (Phoenix 1727010 drawing: wire face 3.6 mm from the pins = footprint local +y; J1 +x, J4 +y, J5 −y), pin order reversed with the nets, silk labels match; U8 pins = SLVSCD5D table 1 (SO: 1 BOOT, 2 VIN, 3 PH, 4 GND, 5 VSENSE, 6 COMP, 7 EN, 8 SS); C17 pads 2.0 mm from the VIN/GND pins, PH via room between them (fig. 55); U8 bottom pad (B.Cu, 4 × 6 mm) and its 1.0 mm-drill via: no bottom part; U5 RC parts 3.6–4.6 mm from pins 1–3, `U5_TJ` a 6.5 mm column, MR 4 mm, all > 20 mm from `U8_PH` / L1. **Fixed:** D4's Path named the removed symbol (05 compares footprint, value, fields and nets, not Path); DRC parity matches by reference and didn't report it, but an "Update PCB" without re-link would delete D4 and re-add it off-board. R30, D4, R3 faced their nets the wrong way (R30 `VOUT` pad away from the VOUT run, D4 `SW1_C` away from SW1, R3 `D3_K` away from D3). C18 0.53 → 1.03 mm from U8. **TVS2 stays by D5 (SPEC 2 "both at J1" not met, accepted):** nothing else hangs on `ACC_IN` between J1 and TVS2, and D5 / R8 sit at the TVS end, so the ~35 mm of trace (≈ 35 nH, assumption 1 nH/mm) is in series ahead of the clamp and protected node: it adds L·di/dt ≈ 2 V at pulse 2a (≤ 56 A in 1 µs) against the 26 V clamp and only slows an ESD edge. A spot by J1 doesn't exist (the J1/J4/TVS1/Q1 gaps are ≤ 5 × 4 mm; SMB courtyard 4.6 × 9.5 mm), and `ACC_IN` or `ACC_S` must cross the BATT/VOUT loop anyway. Routing: `ACC_IN` with no branch before TVS2, TVS2 pad first then D5, TVS2 anode straight into the GND pour. **Accepted, routing rules:** the SW node is ≈ 12 mm (PH pin → bottom → L1 pad 1) vs a few mm in fig. 55; the hot loop (Cin–VIN–GND) is tight and the PH length adds EMI area, not loop inductance; shortening it needs L1 ~4 mm left, onto the VOUT up-run. The `U8_FB` node runs ≈ 15 mm (8.4 kΩ Thevenin), ≥ 8 mm from PH: on top, left of U8, GND alongside. **J4 pin-1 silk triangle** 0.19 mm past the Waveshare-notch edge (DRC `silk_edge_clearance` warning): no board-only fix (editing footprint silk gives `lib_footprint_mismatch`; a `pipwr` copy needs the schematic Footprint field: schematic owned by another agent): the fab clips silk at the outline; lead decision (TODO 4) | 2026-11-05 | 2, 5, 7 |
| **Q1 tab copper: ≈ 0.2–0.4 in², not the 1 in² of the RthJA figure** (staff review A16; assumption) | The Vishay 50 °C/W is for 1 in² × 2 oz, both sides 100 %. Room on `VOUT` here: top x 157.6–175, y 98–106 (≈ 140 mm²) plus the up-run, plus a B.Cu `VOUT` island under the tab with thermal vias (routing). Typical DPAK curves give ≈ 70–90 °C/W at that copper (**assumption**: no curve in the Vishay PDF): TJ ≈ 145–162 °C at 5 A / 9 V / TA 85 °C (0.85 W), ≈ 114–123 °C at 3.5 A, below the 175 °C rating but 20–35 K above SPEC 4's figures. No placement gives more room without moving J4 (fixed). Lead decision in TODO 4 | 2026-11-05 | 4, 5 |
| **Timer sim master = the schematic (KiCad 10 / ngspice), `tools/post_sch/12_kicad_sim.py` + `tools/run_sim.py`; LTspice decks historical** (project lead request, agent A14) | Hand-written decks drift from the schematic. The board parts carry `Sim.*` fields; a sim-only sheet (`simulation.kicad_sch`, excluded from board and BOM) holds the battery, key, SW1 stand-in, Pi load, Pi pull-up, U8 stand-in and the directives. **U5 is a behavioural subcircuit with a real RC oscillator on the RTC / CTC / RS pins at the real values in real time** (not an integrated frequency as in LTspice): the hold follows the actual R27 / C29 / R28 network. Built from ngspice switches, a switched-capacitor charge counter and a time-step guard: B-source comparators let the solver step over the switching instant (period errors of percents), a capacitor-current edge counter miscounted under gear integration (+11 %), XSPICE flip-flops ran 5× slower. The oscillator's hysteresis / driver resistance are calibration knobs set so k = period / (RTC·CTC) lands on design_calc's bounds (2.153 / 2.302 / 2.451 at 5.1 V; the short corner's last −2 % allowance as a C29 factor). No vendor models obtainable (Nexperia HTTP 403, Vishay none for SQD50P04-13L): the LTspice deck's datasheet-derived stand-ins kept. Cost: real time at 1.1 kHz is minutes per scenario; the BATT sweep runs at the short corner only | 2026-11-05 | 3, 4 |
| **Lead layout adopted (`tools/post_route/08_lead_layout.py`, snapshot `lead_layout_2026-11-05.json`); 6 parts adjusted; J2 −0.635 mm x, J5 −2.54 mm x / +0.038 mm y accepted as lead changes (`check_fixed.py --accept-lead-change J2,J5`)** (project lead layout, checked by agent A16) | Kept as the lead placed them: buck row, Q1 / C30 / R14 corner, TVS2 next to J1 (its ACC pad faces J1 pin 2: J1 → TVS2 is 9 mm, then D5), SW1 at the bottom edge (Nidec CAS-120A is top-actuated, "top setting": reachable from above; courtyard 1.1 mm inside the edge, no keep-out), U5 + RC parts, J2 / J5 (inside the outline and clear of keep-outs; J5's 0.038 mm y shift is in the lead's copy, taken as is). **Changed:** R16 to the VSENSE side next to R17 (lead's spot: the high-impedance FB node 0.75 mm from C18's PH pad; SLVSCD5D fig. 55 puts the feedback resistors at the VSENSE pin and routes the VOUT sense round the outside); D3 + R3 below the compensation parts (lead's spot: 0.40 / 0.47 mm gaps, and the only top channel for `VOUT` from Q1 to C15 / C17); R15 above Q5 (its spot was the `VOUT` channel past Q1's `BATT` feed); Q5 +0.5 mm, C19 −0.1 mm (0.30 / 0.49 mm gaps, rule ≥ 0.5 mm). Smallest moved-part gap 0.59 mm. DRC courtyards 0 | 2026-11-05 | 5 |
| **Routing (`tools/post_route/09`–`11`): power as pours, buck by script, the rest Freerouting; DRC 0 errors / 0 unconnected** (agent A16) | **Power:** `BATT` top pour J1 → TVS1 → Q1 source (≥ 3.1 mm, no layer change); `VOUT` Q1 tab → 23 vias (2 × 1.0 mm + 21 × 0.4 mm, < 0.25 A each at 5 A) → bottom pour to J4 pin 1 (TVS2 sits between them on top); top `VOUT` run (≥ 3.3 mm) to the buck input. 3 mm on 1 oz: IPC-2221 external ≈ +9 K at 5 A; IPC-2152 baseline chart (curve fit, no plane: assumption) ≈ +27 K at 5 A, +11 K at 3.5 A; the 5 A runs are pours ≥ 3.1 mm, ≤ 20 mm. `+5V1` top pour, then 0.38 mm necks on both layers between the J2 pin rows (≈ 1.2 A per layer, short). **Buck:** hot loop C17 ↔ pins 2 / 4 straight on top; PH by 2 vias at the pin (≈ 1.5 A each: no room for more between the pins and C17) and 4 at L1, switch node ≈ 12 mm; BOOT via the bottom PH branch (fig. 55); VSENSE line from C24 along the GPIO-notch edge (copper-to-edge rule 0.5 → 0.3 mm, assumption: usual fab minimum) round to R16 on the quiet side. **Q1 tab (lead):** B.Mask opening over the tab (board graphic), feed vias for bottom soldering; `VOUT` copper near Q1 ≈ 231 mm² top (whole `VOUT` top pour) + 185 mm² bottom; θJA estimate 55–70 °C/W (assumption, no Vishay curve; was 70–90): TJ ≈ 132–145 °C at 0.85 W / 85 °C. **Freerouting:** 09 zones as DSN keep-outs, completed nets reduced to one pin, BATT only SW1's feed (0.5 mm); 11 widened its 0.187 mm neck-downs to 0.25 mm and set its vias to 0.6 / 0.3. Bottom copper besides the pours: 124 mm of tracks (longest: SW1's BATT feed 25 mm, ACC_IN 21 mm); GND pours both layers, 33 stitching vias on a 5 mm grid. SS / COMP / FB returns go into the GND pour (fig. 55's separate analog ground trace not drawn: assumption) | 2026-11-05 | 4, 5 |
| **Fab = OSH Park 2-layer; board rules at its floors (`tools/post_route/12_osh_rules.py`)** (project lead 2026-11-05; staff review agent) | The lead named the fab: 1.6 mm FR4 175Tg, 1 oz both sides, ENIG, Er 4.5. **Board Setup floors** (`.kicad_pro`): copper to edge **0.4 mm** (fab 0.381; A16's 0.3 mm broke it), track / space 0.1524 mm, via annular ring 0.127 mm, drill 0.254 mm, via diameter 0.508 mm (drill + 2 rings), hole to hole 0.127 mm, silk text thickness 0.0762 mm. Design values stay in the net classes (Default 0.25 mm / 0.2 mm; Power, Power5V, Switch: 09). **`.kicad_dru`:** slot width ≥ 0.508 mm (no native setting; proven by `12 --selftest-dru`: a 0.408 mm slot fires, a 0.608 mm one does not; the board has no slots). **Mask:** expansion 0.0762 mm (= the fab's alignment: no mask on a pad at worst registration), min web 0.1016 mm; no pad pair merges. **Stackup** (text patch): core 1.524 mm Er 4.5, Cu 0.0356 mm, mask 0.0152 mm, ENIG, total 1.6256 mm; mask Er 3.3 and tan δ 0.02 typical (**assumption**: no fab figure). **Copper moved:** only the `+5V1` VSENSE run along the GPIO notch, y 66.55 → 66.65 mm (0.385 → 0.485 mm from the edge; 0.245 mm to C15's GND pad); zones refilled (pours now 0.40 mm from every edge). **Outline (lead's, unchanged):** every concave corner is r 1.524 mm (notch bottoms) ≥ 0.505 mm (interior tool 1.01 mm) and ≥ 0.86 mm (outline tool 1.72 mm); the r 0.762 / 3.048 mm arcs are convex. **Silk:** footprint lines 0.12 mm (KiCad library) < the fab's 0.127 mm line floor; text 0.12 mm at 0.8 mm OK; DRC can't check silk line width (lead decision, TODO 5). Open vias in the Q1 tab and U8 pad are intentional (solder feed; no filled / plated via-in-pad) | 2026-11-05 | 5 |
| **Routing staff review (08–11): kept, except the fab rules above; no other copper change** (staff review agent, own pcbnew measurements + SLVSCD5D 10.1 / fig. 55) | **Switch node `U8_PH` on two layers: justified, kept.** PH is pin 3 between VIN (2) and GND (4); SLVSCD5D 10.1 says to put PH on "a small copper area directly adjacent to the pin", take it to the bottom by vias, keep that trace short and wide and come back up by vias at the inductor, and route the BOOT branch on the bottom across VIN. Keeping PH on top would push C17 off the VIN / GND pins: the hot loop matters more. As built: C17 pads 2.6 mm from pins 2 / 4 (loop ≈ 9 mm²); PH bottom copper 1.5 × 7.6 mm + 1.0 × 2.4 mm + BOOT branch 0.6 × 4.9 mm (≈ 17 mm²) + L1 pad 1. The 2 × 0.3 mm vias at the pin carry 1.5 A each at 3 A: about 1.2 mΩ and 3 mW each (25 µm plating: **assumption**), so fine. **Power widths, narrowest point measured** (union + erosion bisection; IPC-2221 external, 1 oz, long-trace bound): `BATT` 3.1 mm (at Q1's source; 4.1 mm J1 → TVS1): +8 K at 5 A, +4 K at 3.5 A; `VOUT` bottom tab → J4 5.6 mm: +3 K at 5 A; `VOUT` top tab → buck 1.6 mm: +3 K at 2 A (buck input only); `+5V1` L1 → Cout 2.4 mm: +4 K at 3 A; PH bottom 1.5 mm: +9 K at 3 A. **`+5V1` J2 necks 0.375 mm (top and bottom in parallel):** only about 2 mm from the pour / vias to pin 10 and from pin 10 to pin 1 (the pin gaps leave no more width; the J2 SuperSpeed pins must stay NC). A conducting fin with both ends held at the pin / pour temperature: ΔT_mid = I²R′L²/(8kA) ≈ **0.4 K at 1.5 A per layer** (3 A) and 1.5 K at 3.05 A per layer (6.1 A, U8's highest current limit). The long-trace bound (+17 K at 1.5 A) does not apply at this length. Fusing (adiabatic, 85 °C, one neck): 3.6 A for 1 s; but the neck's thermal time constant is ≈ 4 ms, so conduction governs and the margin is large. **Kept.** **GND:** J1 / J4 GND pins on 4 thermal spokes × 0.5 mm per layer (8 in all, 0.3 mm long, ≈ 0.6 A each at 5 A): kept for hand soldering. TVS1 → 5 × 0.4 mm vias → bottom pour → J1; TVS2 → 1.6 mm top track → J1. Bottom-pour cuts from non-GND bottom tracks total 121 mm (SW1's `BATT` feed 25, `ACC_IN` 21, PH 16, `ACC_G` 13, `Q1_G` 12.5, `ACC_N` 9, COMP 8, rest ≤ 7 mm), against about 50 mm in the trial. No island and the pour stays one piece; the cuts carry signal current or lie along slow nets: **minor, not fixed**. 33 stitching vias on a 5 mm grid. **Distance from PH copper:** U5 RC / MR / RS nets ≥ 20 mm, `HOLD_G` 15.7 mm, FB 3.9 mm, SS 3.6 mm; COMP / CRC 1.4–1.6 mm (R18 next to C18's PH pad, lead placement): about 30 mV coupled into COMP's internal 20.7 pF (estimate). **Minor, kept.** SS / COMP / FB returns go to the bottom pour (A16 assumption): the pour under that corner carries no power current, so agreed. PowerPAD: 1.0 mm centre via + 10 × 0.3 mm, a 4 × 6 mm bottom pad solid in `GND_BOT`. **Q1 tab:** the B.Mask opening (37.1 mm²) lies wholly over `VOUT_BOT` copper (no other net, no mask negative or keep-out); the footprint's F.Paste is harmless (no stencil); θJA estimate 60–80 °C/W with ≈ 0.64 in² of `VOUT` copper over 2 layers (**assumption**), TJ 136–153 °C at 0.85 W / 85 °C (< 175 °C). **Freerouting artefacts:** 0 endpoint near-misses (≤ 2 µm), 0 duplicates, 0 zero-length, 0 acute angles, all items locked; every via without a track is intentional (GND stitching, `VOUT` tab vias); 4 kinks < 0.1 mm on `ACC_G` / `U5_RS` / `U5_TJ` (cosmetic, left). **Silk:** DRC silk-over-copper 0; J1 (BATT / ACC / GND), J4 (12V / GND) and J5 (ACC_N / GND) labels match the pins | 2026-11-05 | 2, 4, 5 |
| **Right-edge notch: BACK HEADER KEEPOUT strip cut out, x 185.166–192.024, y 70.450–102.000 (`tools/post_route/13_right_notch.py`)** (project lead 2026-11-05, approved geometry; no review requested) | The CAN FD HAT under this board (turned 180°) has its vertical pin header under the strip. The cut stops short of the full keep-out (y 64.49–107.98) because the MH2 / MH4 corner tabs join the board only through the material between the top / bottom notch and the cut: the lead asked for necks ≥ 5 mm. Measured on the saved Edge.Cuts arcs: top neck **5.009 mm**, bottom **5.024 mm** (fillet to fillet). The approved top edge y 70.440 gave 4.9995 mm, so it moved 10 µm into the cut (70.450); the bottom edge stays at 102.000. Inner fillets r 1.524 (≥ OSH Park's 0.505 interior milling radius), outer corners r 0.762 like the other tabs. 7 GND stitching vias in the strip deleted; the 5 vias at x 184.47 (0.39 mm from the new inner edge, rule 0.4) moved to x 184.2. J1 / J4 pin labels moved 0.07 mm inward (0.157 mm from the edge: **assumption**, margin for the fab's routing tolerance; the DRC silk-to-edge rule is 0). New DRC warning, accepted like J4's: J2's footprint silk line at y 82.65 runs past the new edge (J2 body overhangs the cut by intent; the fab clips silk off the board; clipping it on the board would give `lib_footprint_mismatch`). Baseline: `check_fixed --accept-lead-change EDGE_RIGHT_NOTCH` | 2026-11-05 | 5 |
| **Right-edge notch top edge moved down under the USB port J2: notch now x 185.166–192.024, y 85.000–102.000 (`tools/post_route/14_notch_under_usb.py`)** (project lead 2026-11-05: "Keep board under the USB port (J2). It's going to block underneath it anyway, so we may as well have board under it. I'm not using the header it covers."; agent A19) | J2's body covers that part of the back header anyway, so the strip under it is board again. Top edge = 85.000: J2's courtyard ends at y 84.555 (pcbnew), limit courtyard + 0.2 mm rounded up = 84.76; 85.000 is the brief's value and clears it. Same corners (mouth r 0.762, inner fillet r 1.524); bottom edge and its arcs unchanged; the five top path items replaced with exact shared endpoints. Measured necks: top **19.170 mm** (was 5.009), bottom 5.024 mm. 3 GND stitching vias back in the restored strip at x 189.47, y 70.89 / 75.89 / 80.89 (script 11's grid; each ≥ 0.4 mm from the edge, held by both GND fills, holes ≥ 0.5 mm apart); they sit under J2's body (GND via under a GND shell: harmless). J2 pad copper ≥ 1.336 mm from the edge. J1 / J4 labels unchanged (0.157 mm edge gap). The PoE rule area (B.Cu, no footprints) is on the board again. J2's silk_edge_clearance warning is gone. Baseline: `check_fixed --accept-lead-change EDGE_RIGHT_NOTCH_UNDER_USB`; 13 becomes historical | 2026-11-05 | 5 |
| **Sim fast mode = U5 count scaled (CD4541B model `TAPDIV`, 2^15 / 256 counts on the real R27 / C29 / R28), hold extrapolated with the measured period; not a scaled C29** (staff review of `tools/post_sch/12`, `tools/post_sch/13_sim_fast_review.py`) | The CPU cost is one solver landing per oscillator edge (≈ 37 s CPU per oscillator-second), so a faster oscillator would cost the same for the same 32 768 edges. Counting fewer edges at the real frequency keeps the oscillator, the supply and every edge-to-edge sequence real; `hold_est` = measured hold + (32 768 − 128) × t_osc (CTC edges 16–80), guarded by a count check (U5 OUT falls at 128 ± 2 counts, else no hold). Fast vs real time: within 15 ms (0.05 %) in every scenario (`reports/sim_kicad.md`). `verify-sch` sim: 14 scenarios + 6 broken decks in ≈ 1.5 min (was 16 min for 3) | 2026-11-05 | 3 |
| **Simulator GUI default = the fast nominal key cycle (6 s transient, U5_TAPDIV 256, no interp); real time only through `pdm run sim --full`** (staff review; assumption: the lead wants a usable GUI default) | The 50 s real-time default ran 20+ min in Eeschema. The real-time settings are one `.param` / `.tran` / `.options` change, written on the sheet | 2026-11-05 | 3 |
| **FET stand-ins: VTO_N / VTO_P are datasheet V_GS(th) at 250 µA (the model converts them to V_to); Q1 ksubthres 30 mV, Q5 / Q6 0.1 V; C_gd × 1.8 in the hot-plug runs** (staff review) | VDMOS V_to is where the square law starts, not the 250 µA point: the old corners sat 0.1 V (N) / 0.06 V (P) off the datasheet thresholds. 30 mV on the N-FET stalled the solver at key-on (CD4541B tap switches); 0.1 V gives more sub-threshold current than silicon, conservative for a parked Q5. Model C_rss is 0.92 / 0.49 / 0.41 nF at 1 / 5 / 12 V against the Vishay typical curve ≈ 1.25 / 0.70 / 0.45 nF; × 1.8 covers the maximum (× 440 / 352) at 1–25 V. Hot-plug at 16 V, hot, maximum C_gd: `VOUT` 38 mV (leakage), PASS | 2026-11-05 | 3, 4 |
| **CD4541B model: the "done" comparator hysteresis 0.2 mV (was 5 mV = 5 counts)** (staff review) | With 1 mV per count the 5 mV switch hysteresis made the output change 5 counts late (32 773, + 4.5 ms). Found by the fast mode's count check | 2026-11-05 | 3 |
| **The sim's delay is not an independent check of the k bound** (staff review finding) | U5's HYS / RDRV / C29 factor are fitted so the model k equals design_calc's 2.104 / 2.3 / 2.450, and the LTspice deck used the same bound: sim = calc by construction. SCHS085E gives only the typical k = 2.3, no limits. The ≥ 25 s guarantee rests on design_calc's fig. 2 analysis plus its 2 % allowance; the sim proves the sequence, levels and turn-off. Bench: measure f_osc (CTC pin) on both boards, room and hot / cold if possible (TODO) | 2026-11-05 | 3 |
| **`tools/post_sch/12_kicad_sim.py` guard extended (no change to what it writes)** (staff review; outside the reviewer's listed files, recorded) | 13 rewrites the sim sheet's three text items; without the extension 12's re-run stops ("sheet differs"). 12 now also accepts exactly `13.expected_sim(12's sheet)` and reports "already applied" | 2026-11-05 | 7 |
| **Resistors: Vishay Dale CRCW e3 thick film for every resistor, all 1 % / ±100 ppm/K / AEC-Q200 (0805 0.125 W, 1206 0.25 W)** (BOM phase, A18) | One family and one datasheet for 15 lines; the datasheet has the single-pulse chart R30 needs (CRCW1206 ≈ 8 W at 1 ms vs the 0.35 W clamp pulse, SPEC 4); every value stocked in cut tape (≥ 7 000); $0.10 each at 7. R3 / R21 / R26 / R29 are not 1 % in SPEC 7 but are bought as 1 % (same price, one tolerance in the drawer). Panasonic ERJ / Yageo RC would do too | 2026-11-05 | 6 |
| **C15 = Cal-Chip GMC31X7R106K50NT (10 µF 50 V X7R 1206)**, not a Samsung / TDK part (BOM phase) | Samsung CL31B106KBHNNNE (datasheet in `ref/`), TDK C3216X7R1H106K160AC and CGA5L1X7R1H106K160AC: 0 stock on Digi-Key (2026-11-05). The GMC part is stocked (140 k) and shares the Cal-Chip datasheet with C8 / C22–C24. Its DC-bias curve is not published in that datasheet: the ≥ 5 µF at 14.4 V (SPEC 4) is a bench item | 2026-11-05 | 4, 6 |
| **C17 / C18 / C30, C19, C20: KEMET C0805C…K5RACTU (X7R ±10 % 50 V)**; C29 KEMET C0805C103F5GACTU (C0G ±1 %) kept | KEMET publishes the X7R and C0G series datasheets (now in `ref/`); millions in stock; Samsung CL21B153KBANNNC (15 nF) is obsolete | 2026-11-05 | 6 |
| **U8 ordered as TPS54336ADDA (tube), Parts Mount `SMD (tube)`** | TPS54336ADDAR (reel / cut tape) shows 0 stock; the tube is stocked (6 672) and MOQ 1. Same die and package (TI: DDA = SO PowerPAD-8, no R = tube). `tools/digikey_lookup.py` applies the cut-tape rule only to Mount `SMD` | 2026-11-05 | 6 |
| **Spares: Spares `yes` = 10 % rounded up, at least 5; `+N` = N (ICs, Q1, L1, SW1, connectors)** (`tools/digikey_lookup.py` `spares_for`) | Hand assembly: a dropped 0805 or SOT-23 is cheaper to replace than to find; 10 % of 2–6 parts would round to 1. ICs and connectors cost more and are not lost as easily: +1 or +2. Some lines would cost less at the 10-piece price break (e.g. C29: 10 for $25.96 vs 7 for $26.25): not optimised | 2026-11-05 | 6 |
| **`dk-check` value / package checks rewritten (`tools/digikey_lookup.py`)** | The SLAB rules compared every Value / Package cell with the Digi-Key Resistance / Colour / Package text and failed every semiconductor and connector row. Now: Package only for a chip size code (0805 …); Value for resistors (value, tolerance, power, TCR as stated), capacitors (value, voltage, dielectric, tolerance as stated) and colour-word LEDs; other rows rely on the MPN. Negative tests run by hand (scratch script): wrong value, tolerance, power, TCR, voltage, dielectric and colour each FAIL | 2026-11-05 | 6 |
| **Parts table: one row per MPN** (J4 + J5, R17 + R31, C17 + C18 + C30 merged) | The BOM CSV gets one line per Digi-Key PN, and `tools/post_sch/14` maps refs to one PARTS entry each | 2026-11-05 | 6 |
| **`tools/check_netlist.py` selftest spot check: J5 value "ACC_N GND"** (outside A18's listed files, recorded) | The spot check hard-coded SPEC 7's old J5 value; with the lead's new value (`tools/post_sch/14`) it would stop the selftest. One string, no check logic changed | 2026-11-05 | 7 |
| **D3 = Stanley VFR1105W-6C9-TR (red 1206 / 3216 dome lens, −40 to +100 °C), R3 5.1 kΩ kept** (BOM staff review; `tools/post_sch/15_bom_review.py`) | LTST-C150KRKT is rated −30 to +85 °C (Lite-On), short of a car cabin. Candidates read from their datasheets: Kingbright APT3216LSECK/J3-PRV, APTR3216SECK/J3-PRV, APTL3216SURCK-01, APTD3216LSURCK, Lumex SML-LX1206SIC-TR: all −40 to +85 °C; Broadcom HSMC-C370 storage −40 to +85 °C; Osram LS R976 not on Digi-Key; Würth 150120RS75000 datasheet download refused. Stanley's 1105W "High Reliability V-Series" datasheet: Topr −40 to +100 °C, made for car indicators, 3.2 × 1.6 mm (fits the LED_1206 HandSolder pads: Stanley's pattern: 1.3 × 1.6 mm pads, 2.0 mm gap, 4.6 mm overall; KiCad's 1.425 × 1.75 mm, 1.55 mm gap, 4.4 mm overall), V_F 1.9 typ / 2.4 max V at 20 mA (Lite-On 2.0 / 2.4): the current changes by a few %, so R3 stays. 1 601 cut tape in stock (7 needed); $0.38. **Assumptions:** the datasheet is the series sheet (part number V□□1105W-TR) and "6C9" is a rank code inside it (rank windows are ≥ 4 ranks wide, so "C9" plausibly = C9–CZ, 470–1 000 mcd, which holds Digi-Key's 985 mcd; the series sheet gives 330 min / 450 typ / 1 200 max mcd at 20 mA); FR1105W-TR (non-V, 8 692 stock) was not chosen because Digi-Key links it to the same V-Series sheet, so its own rating is unverified. About 9–18× brighter than the Lite-On part at the same current (rank window vs Digi-Key's 985 mcd): lead may raise R3 | 2026-11-05 | 4, 6, 7 |
| **C29 = Murata GCM21B5C2E103FX0AL (10 nF C0G ±1 %, 250 V, AEC-Q200, 0805)**, was KEMET C0805C103F5GACTU (BOM staff review; `tools/post_sch/15`) | Same role figures (C0G 0 ± 30 ppm/K, ±1 %, −55 to 125 °C: Murata sheet in `ref/`), automotive-grade, $0.68 vs $3.75 each at 7: −$21.5 on the order. 250 V ≥ the 50 V the SPEC 7 Value states: the Value is kept (no schematic / board Value change). 2 089 cut tape in stock | 2026-11-05 | 3, 6 |
| **`dk-bom` CSV is now guaranteed ASCII** (`tools/digikey_lookup.py`: `CSV_ASCII` + `−`, `→`, `·`, `≈`, `²`, `≪`; an unmapped symbol stops `dk-bom`; `dk-selftest` checks every spec row) (BOM staff review) | The phase-6 CSV carried U+2212 and U+2192 in 9 lines although `_ascii()` exists for BOM Manager / Excel imports. Not a check rule change | 2026-11-05 | 6 |
| **BOM staff review, no change** (record) | Every MPN re-checked against its SPEC 2–4 role and its datasheet: voltage (SMBJ16A clamp 26 V vs U8 28 V operating, Q1 40 V, 1N4148W 75 V), dielectric (C29 C0G, buck caps X7R; DC bias stays a bench item, the loop is checked down to 25 % retention), resistor power (R30 pulse: 14's record; R21 0.17 W at 16 V vs 0.21 W derated at 85 °C: SPEC 6 note), R27 / R28 1 % 100 ppm/K, every SMD Digi-Key PN = the cut-tape variation with stock ≥ order. **Rated to only 85 °C or less (no same-footprint alternative sought, lead):** J2 −20 to +85 °C and 1.8 A per VBUS contact (Digi-Key; no Molex PDF), SW1 −40 to +85 °C, U8 TA −40 to +85 °C (Digi-Key; TJ −40 to 150 °C, SLVSCD5D). SW1 contact rating 24 V / 25 mA switching (Nidec), 0.3 mA used. J1 / J4 / J5 are 10 A IEC / 12 A max (Phoenix), not 13.5 A (a Digi-Key figure): Value text corrected | 2026-11-05 | 2–4, 6 |
| **Review of the BOM staff review: D3 / C29 swaps, `tools/post_sch/15`, `digikey_lookup.py` ASCII guard confirmed; doc text corrected** (record, staff review 2) | Checked from the datasheets: Stanley 1105W V-Series Topr −40 to +100 °C, DC 30 mA flat to 75 °C (≈ 5 mA at 100 °C) vs ≤ 2.75 mA at 16 V; package 3.2 × 1.6 mm fits the KiCad LED_1206 HandSolder pads; Stanley numbers its pins the other way (pin 1 = anode, cathode mark at pin 2): harmless, the checklist orients by the cathode mark / KiCad pad 1 = K. Murata GCM21B5C2E103FX0A: 5C = C0G, 2E = 250 V, F = ±1 %, −55 to 125 °C, L = 180 mm reel. R21 0.17 W vs 0.206 W (CRCW1206 P70 0.25 W, 155 °C film) at 85 °C; Phoenix 1727010 / 1727023 10 A IEC / 12 A max, UL AWG 30–16 (note: IEC stranded max 1 mm², ≈ AWG 18; AWG 16 only solid). SW1 CAS-120TA = washable with seal tape (Nidec). 15: guards, idempotent ("already applied"), schematic diff vs the 192919 backup = the 11 D3 / C29 fields only. **Fixed (low, text):** DECISIONS D3 row claimed a 1.9 mm KiCad pad gap (it is 1.55 mm) and "985 mcd fits rank C9" (C9 alone is 470–560 mcd; a ≥ 4-rank window C9–CZ holds it); brightness "≈ 18×" / "≈ 100 mcd at 2 mA" overstated → 9–18× / 50–100 mcd (SPEC 4, TODO) | 2026-11-05 | 4, 6 |
| **L1 15 µH SRP1038A-150M (was 10 µH -100M)** (agent A22, U8 datasheet review) | SLVSCD5D 8.2.2.6.1 allows K_IND "as high as 0.3" with ceramics; 10 µH gave 0.34 at 16 V (eq 19: L_min 11.3 µH). 15 µH: K_IND 0.23 (0.35 only with L −20 % and fsw min together), I_sat 10 A > the 6.5 A current-limit max, I_rms 6.25 A vs 3.01 A, DCR 45 mΩ max (+0.14 W vs the 10 µH). Same series and footprint, stocked (9 422). 22 µH rejected: I_sat 7 A, DCR 74 mΩ | 2026-11-06 | 4, 6, 7 |
| **C31: second 10 µF 50 V X7R 1206 at U8 VIN** (agent A22) | Eq 17 gave 441 mV p-p with one 10 µF at 50 % retention, over the 400 mV of the TI example (8.2.2.5). Two: 227 mV (282 mV at fsw min). Same part as C15 (no new MPN). Fewest-part fix: a single 22 µF 50 V needs a 1210 and has no DC-bias curve either. Retention stays an assumption (no Cal-Chip curve) | 2026-11-06 | 4, 6, 7 |
| **C32: fourth 47 µF 10 V X7R 1210 on `+5V1`** (agent A22) | Eq 22 (1.5 A step, 5 %) needs 34.8 µF; 3 × 47 µF at the assumed 25 % low-corner retention gave 35.2 µF (1 % margin). The lead asked ≥ 20 %: 4 × 47 µF gives 47 µF (35 %). A vendor DC-bias curve could have saved the part, but none is obtainable (Cal-Chip publishes none; Murata / TDK / Samsung refuse scripted downloads) | 2026-11-06 | 4, 6, 7 |
| **FB R16 / R17 73.2 k / 13.7 k (was 53.6 k / 10.0 k): VOUT 5.074 V** (agent A22) | Worst case was 5.252 V > USB 5.25 V. E96 search (`design_calc._fb_search()`, R17 10–20 kΩ) for the largest smaller margin with VREF ±1.5 % (6.5, over TJ), 1 % resistors and a 0.1 V board + connector drop at 3 A (assumption): 4.915–5.238 V at the sense point, ≥ 4.815 V at the port. Nominal 15 mV lower. FB node 11.5 kΩ (TI example 16 kΩ) | 2026-11-06 | 4, 6, 7 |
| **R18 7.32 k (was 5.49 k), C20 15 nF kept** (agent A22) | Eq 10 at fc 30 kHz with the new Co (4 × 47 µF × 34 %) gives 7.35 k; eq 12 gives 14.8 nF. Loop model (7.3.15 Roea / Coea, sampling Q 0.3–1): fc 16.2–41.7 kHz, PM ≥ 51° over 25–60 % retention and 0.1–3 A | 2026-11-06 | 4, 6, 7 |
| **Buck re-layout: U8 power block below J5; FB / COMP / SS at their pins on F.Cu; analog ground traces to the PowerPAD** (agent A22, `tools/post_route/16`) | SLVSCD5D 10.1 / fig. 55. J5 (fixed) left only 2 mm beside U8's FB pin at the GPIO-notch edge, so the divider could not sit at pin 5 without moving U8. U8, C17, C15 and their copper moved as one rigid block (−1.3, +9.205 mm): the hot loop is unchanged and the left side of U8 is free. `U8_FB` 18.6 → 5.5 mm; COMP from B.Cu (1.37 mm from PH) to F.Cu; PH B.Cu ≈ 10 → 7 mm. Analog ground as a separate trace (10.1) instead of the pour: R17 / C19 / C20 return to the PowerPAD ends (the pad is U8's ground: one point), keep-out `AGND_KEEPOUT` (F.Cu, zone fill only). L1 +1 mm (C15 gap), C31 / C32 placed, D3 silk reference to F.Fab (over C18's PH pad). Courtyard gaps ≥ 0.5 mm. `check_fixed` selftest now mutates only the lead's rule areas (a later keep-out is allowed) | 2026-11-06 | 5 |
| **`run_sim.py` sorts the exported deck's elements by name** (agent A22) | kicad-cli writes elements in sheet item order; inserting two sim-excluded capacitors (C31 / C32) reordered the deck and two fast scenarios stopped with "timestep too small" at key-on (same circuit). With sorted elements and the new U8 stand-in values (V5SET 5.07 V, C5V1 64 µF, CIN_U8 10 µF, RFB 86.9 kΩ) all 14 pass | 2026-11-06 | 3 |
| **Staff review R22 of the U8 fixes: values and layout kept; calc sweep and text corrected** (record) | Recomputed eq 15–24, 10–12 from SLVSCD5D and the SRP1038A table: all match. `design_calc.buck()` now sweeps fsw 272 / 340 / 408 kHz in the loop (sampling pole at fsw / 2): PM ≥ 45.8° (was reported ≥ 51°, fsw typ only), fc 15.9–42.4 kHz; it also prints eq 22 at fsw min (43.5 µF, 8 %) and the loop-based step (≤ 155 mV vs 254 mV). Kept 4 × 47 µF (TODO assumption). Analog ground text corrected: two landing points on pad 9, not one. Fixed: SPEC "post_route/16–17" (no 17), C32 missing from the 10 V capacitor note, the stale assembly checklist (R16 / R17 / R18 / L1 values, C31 / C32 missing), a misplaced comment in post_sch/16, `run_sim.canonical_order()` now refuses an inline `.subckt` | 2026-11-06 | 4, 5, 6 |
| **Lead layout edits 2026-11-09 adopted as made in the master (buck block); references from F.Fab to silk; track debris removed (`tools/post_route/17`)** (project lead review; agent check) | The lead edited the masters in place (not the copy; new working mode). Schematic: same 42 nets, parts and fields as the commit (`kicad-cli` netlists compared), layout only. Board: C22 / C23 / C24 / C32 11.7 mm left beside U8 / R16 (VSENSE taken at C32 by a 2.7 mm trace; Cout GND return to U8 shorter), L1 turned 90 deg (PH pad at the bottom: PH B.Cu ≈ 7 → 12 mm, more switch-node area: **accepted** by the lead), P5V_TOP extended to x 145.67. Agent findings, resolved by the lead in the GUI: R17's turn put its GND pad outside `AGND_KEEPOUT` and in the GND pour (R17 turned back; pad clear of every pour again); a new third PH via pushed C17 1.07 mm off the VIN / GND pins (pad centres 3.58 → 4.65 mm): the lead moved the via north to (153.03, 77.52) and C17 west, now 4.12 mm; the via trims the GND_TOP edge between pin 4 and C17 by ≈ 0.8 mm over ≈ 1 mm with ≥ 3 mm of pour beside it: accepted. **References:** 06 / 11 / 16 had put every reference that overlapped copper or silk on F.Fab; the lead wants them on silk. 17 placed 28 of 30 clear of pads, vias, silk and other bodies; C18 and R16 have no spot and are left over their pads (DRC `silk_over_copper` warnings) for the lead to hand-place. **Debris:** 9 micro-segments deleted with the neighbour ends snapped (≤ 50 µm), clearance-checked (a first try moved a `U5_RS` end 23 µm toward U5 pin 4: 0.1945 < 0.2 mm; the other end is kept now). DRC 0 errors / 0 unconnected / 0 parity | 2026-11-09 | 5 |
| **Thermal reliefs on pads in every pour; solid only on U8, Q1, C17, C32 pad 1 (`tools/post_route/18`)** (project lead 2026-11-09) | 09 / 11 left SMD pads solid in every pour (GND: KiCad's THT-only default; power pours solid for current), which on 1 oz both sides with 5 mm GND stitching needs a preheat for every part. Spokes 4 × 0.5 mm × 0.3 mm: ≈ 0.07 mΩ per pad (nothing here), ≈ 0.1–0.3 nH (matters only in the U8 hot loop). Solid kept where copper is the function: U8 PowerPAD (ground and heat), U8 VIN / GND pins + C17 (hot loop, SLVSCD5D 10.1; preheated with U8 anyway), Q1 tab (heatsink). C32 pad 1: one spoke fits at the P5V_TOP strip end (DRC starved_thermal), solid instead. J1 BATT / J4 VOUT at 5 A on 8 spokes (2 layers), like their GND pins (routing staff review). DRC 0 errors / 0 unconnected / 0 parity | 2026-11-09 | 5 |
