crxguy52/pi-car-power-supply/reports/placement_fab_silk.png

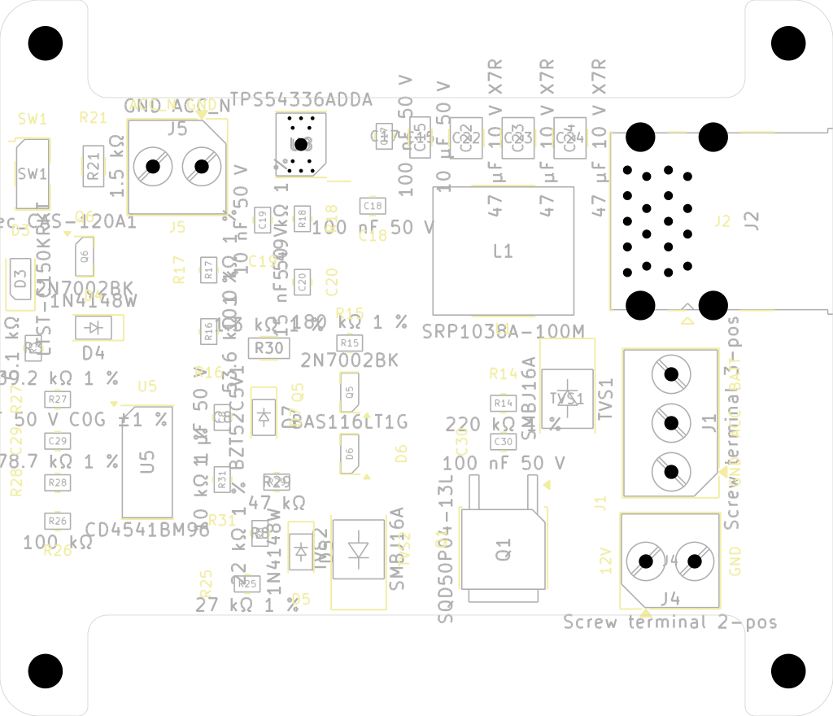
reports/placement_fab_silk.png
