crxguy52/pi-car-power-supply/reports/placement_top.png

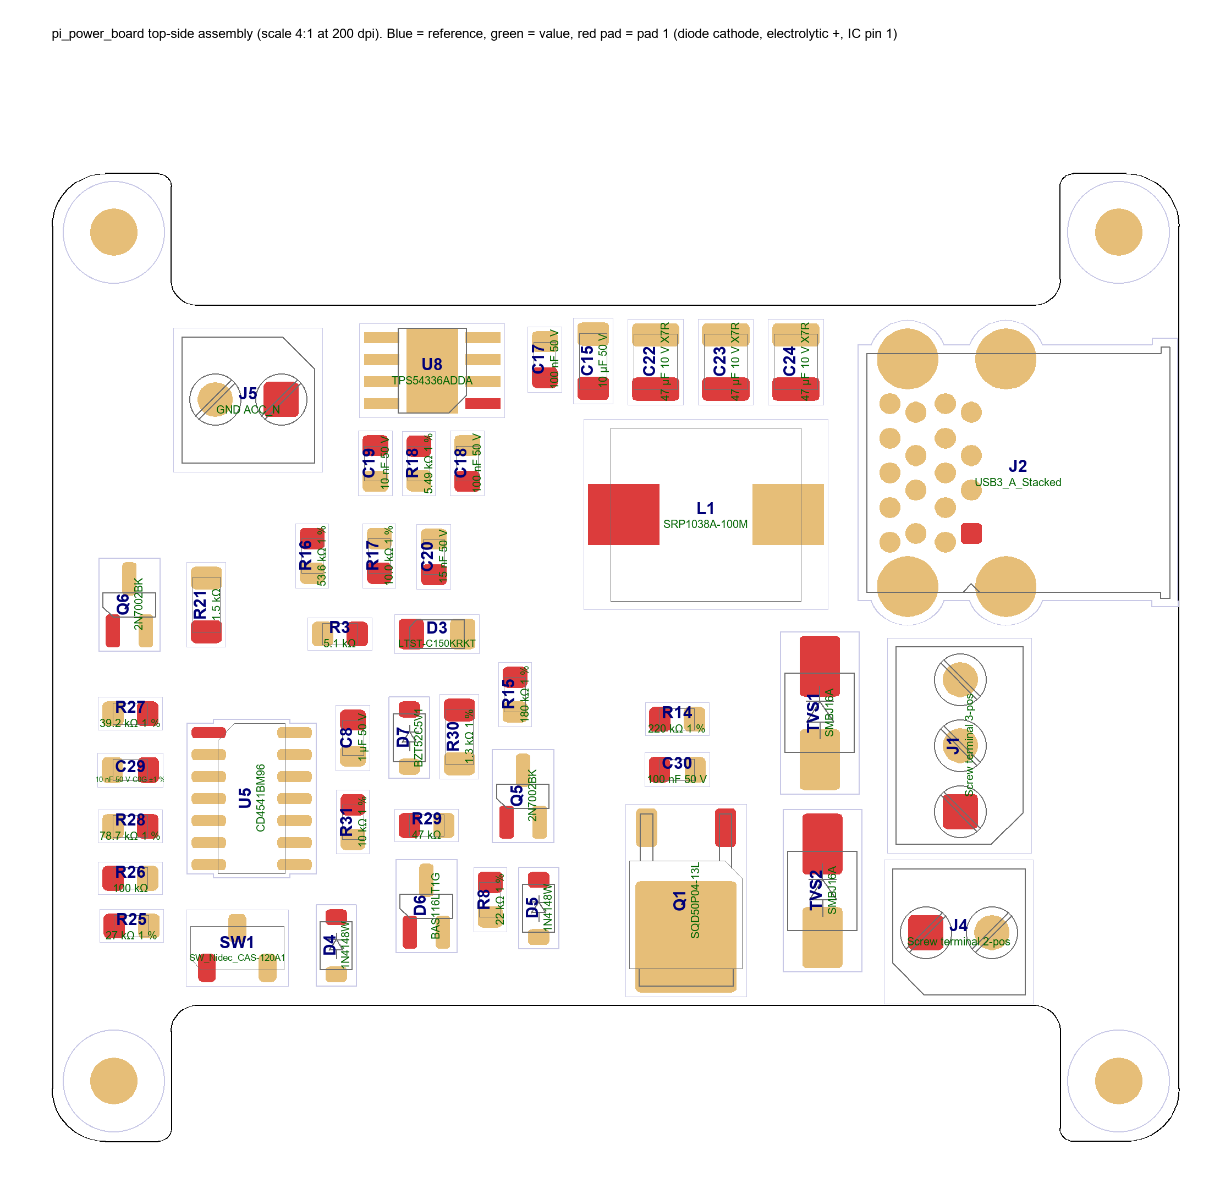
reports/placement_top.png
