crxguy52/pi-car-power-supply/reports/routed_3d_top.png

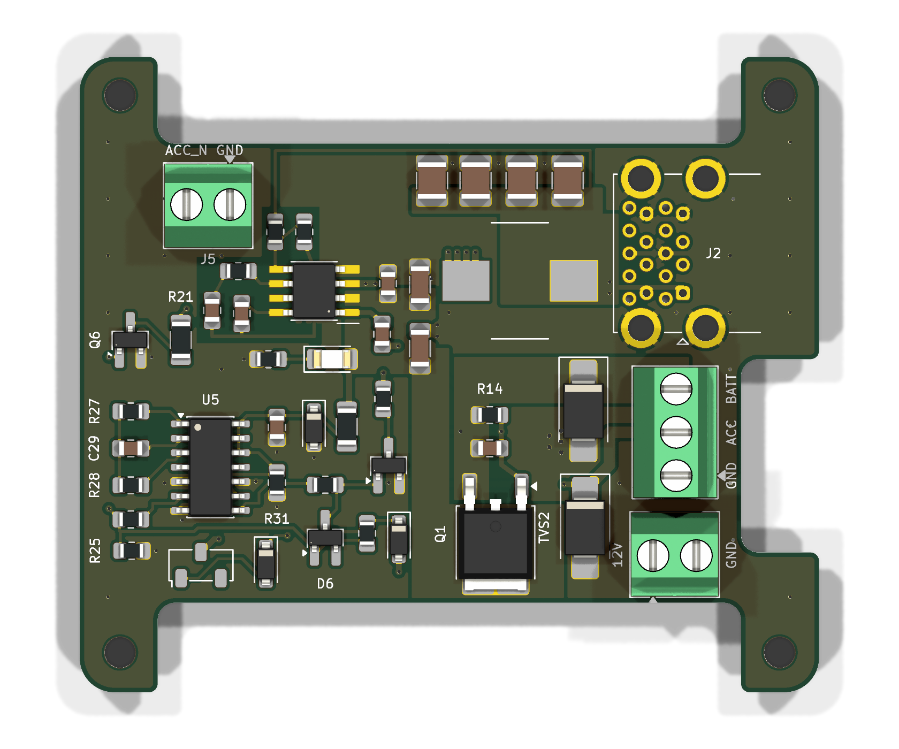
reports/routed_3d_top.png
