crxguy52/pi-car-power-supply/reports/routed_bottom.png

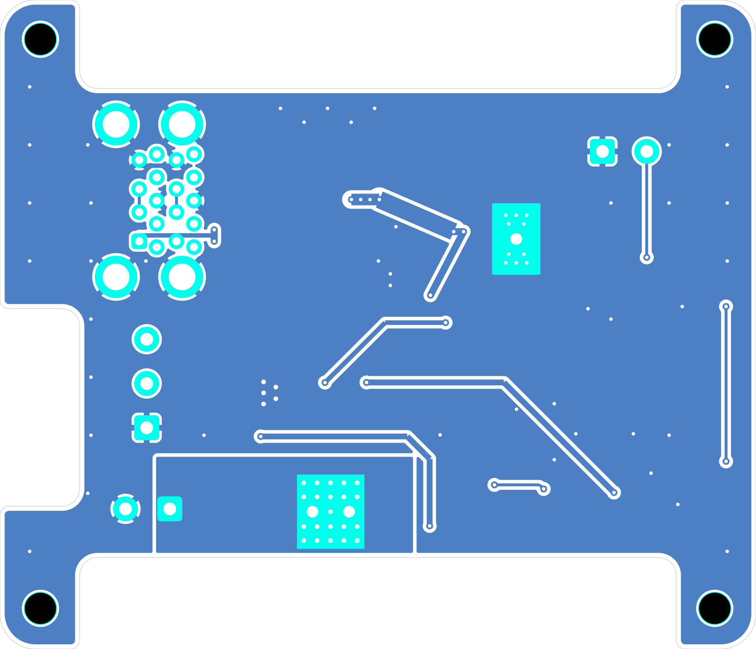
reports/routed_bottom.png
