crxguy52/pi-car-power-supply/reports/routed_top.png

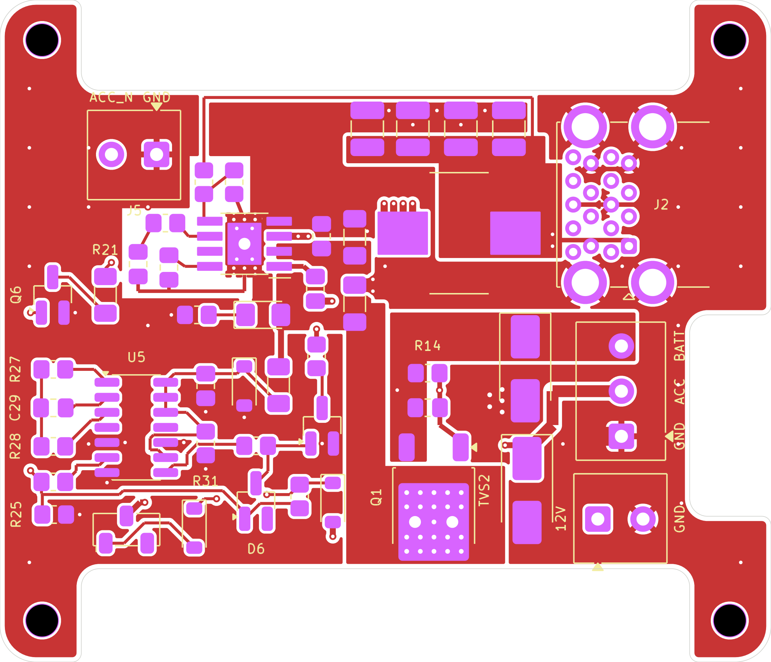
reports/routed_top.png
