crxguy52/pi-car-power-supply/reports/schematic.png

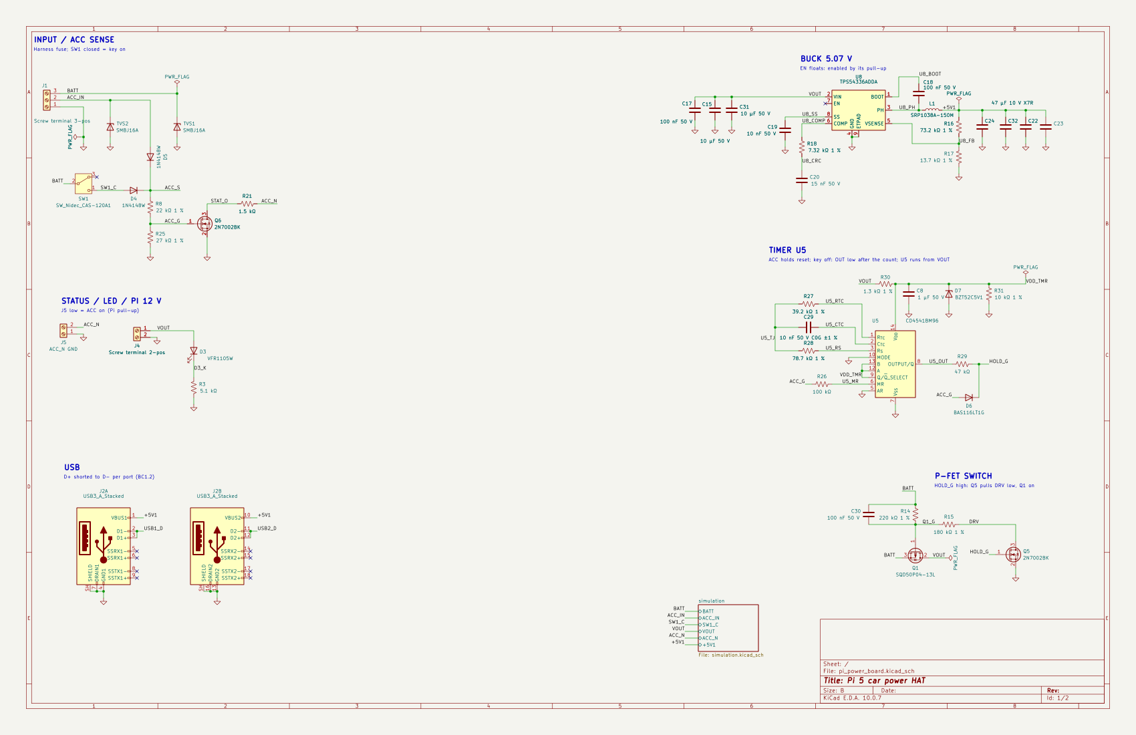
reports/schematic.png
