crxguy52/pi-car-power-supply/reports/sim_delay_off_12V_nominal.png

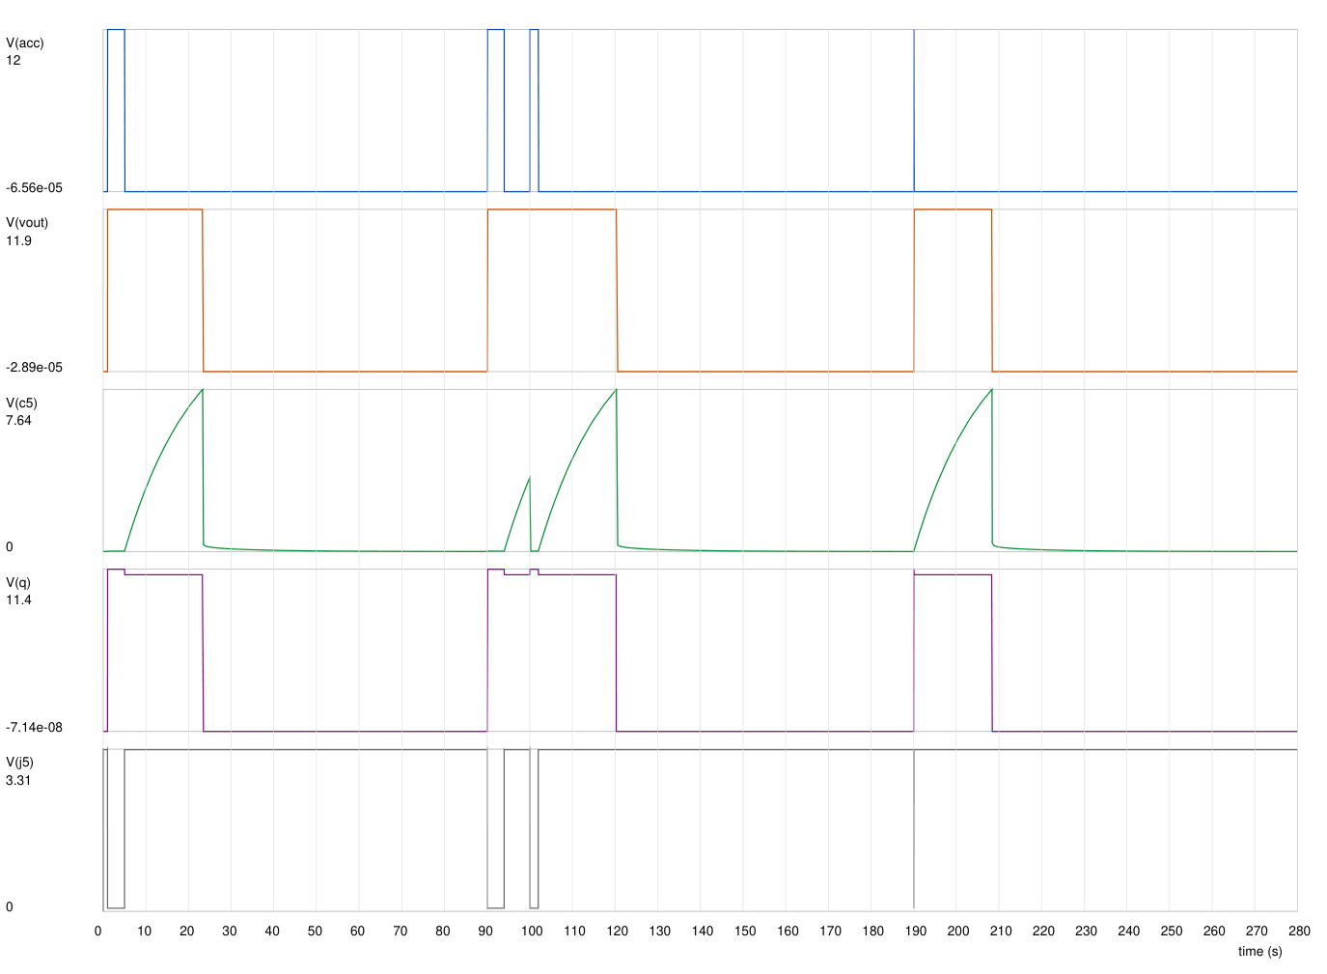
reports/sim_delay_off_12V_nominal.png
