crxguy52/pi-car-power-supply/reports/sim_delay_off_SW1_12V_nominal.png

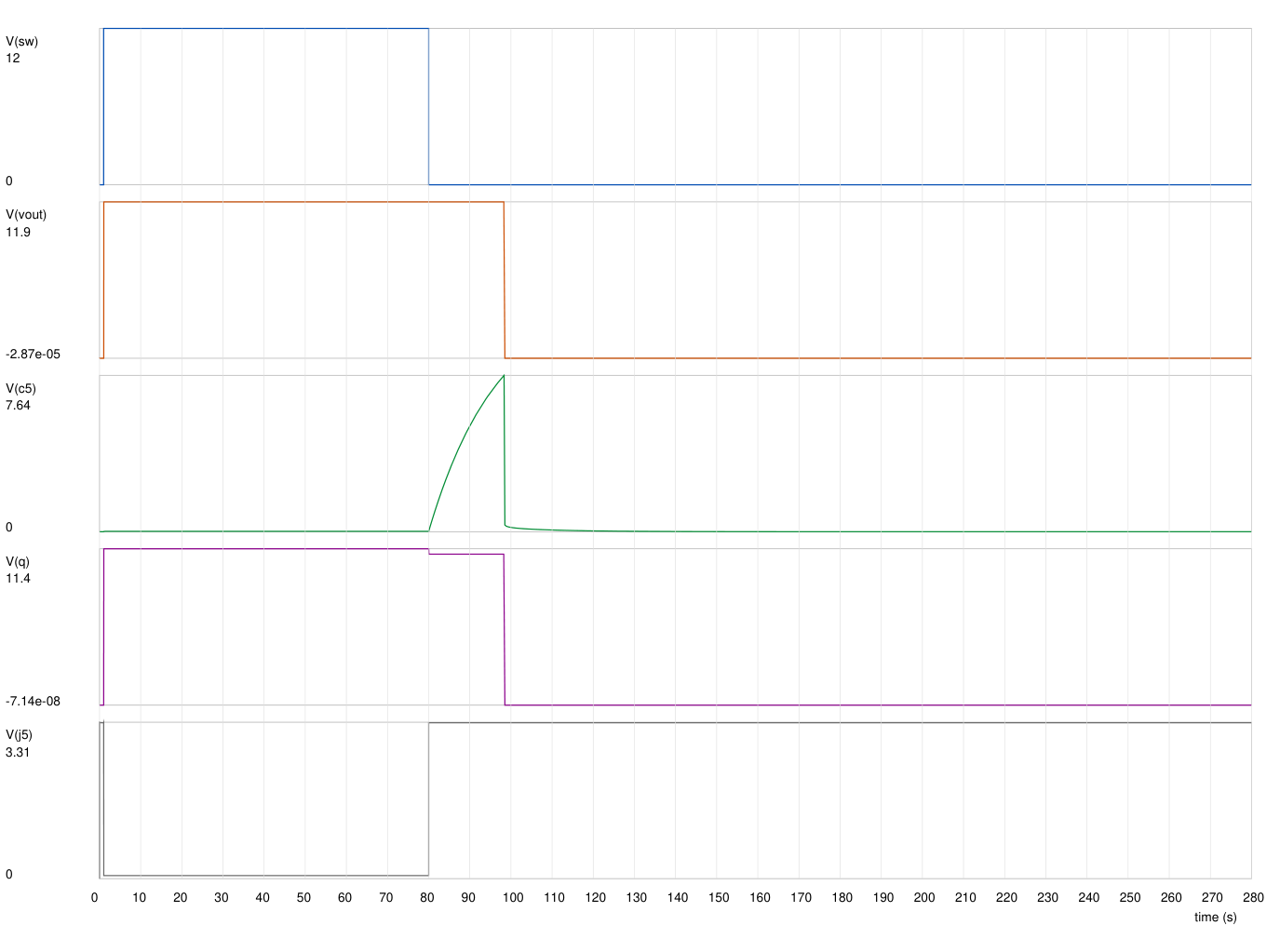
reports/sim_delay_off_SW1_12V_nominal.png
