crxguy52/pi-car-power-supply/reports/original_layout.pdf

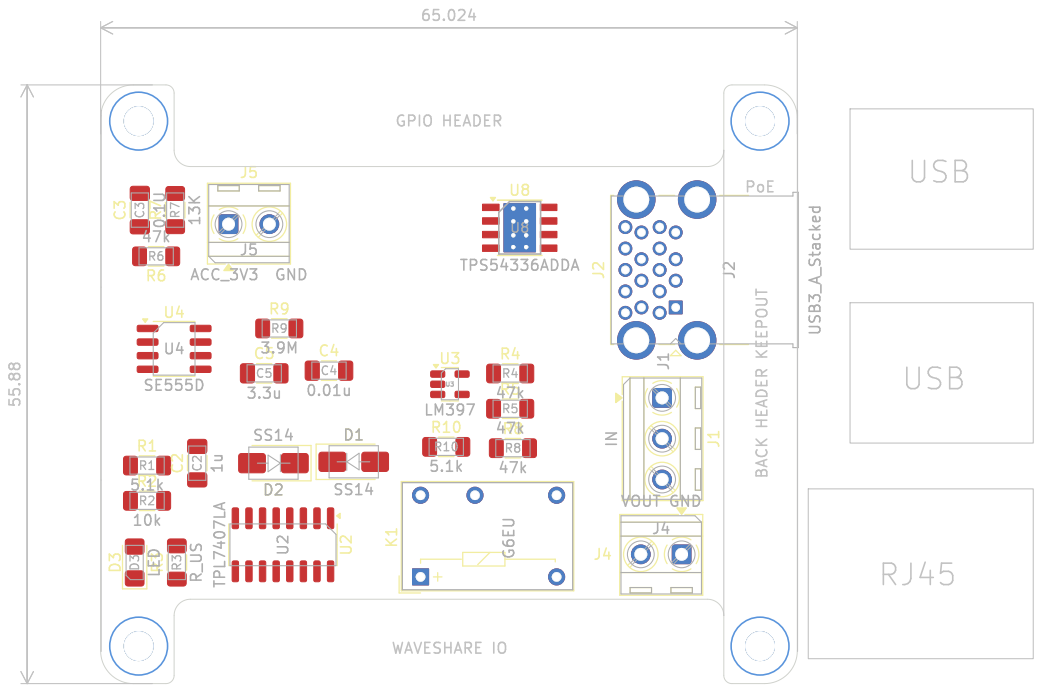
[picture p23: page 1]

USB BACK HEADER KEEPOUT GPIO HEADER WAVESHARE IO 55.88

Id: 1/1 Title: File: pi_power_board.kicad_pcb Sheet:
