crxguy52/pi-car-power-supply/reports/original_schematic.pdf

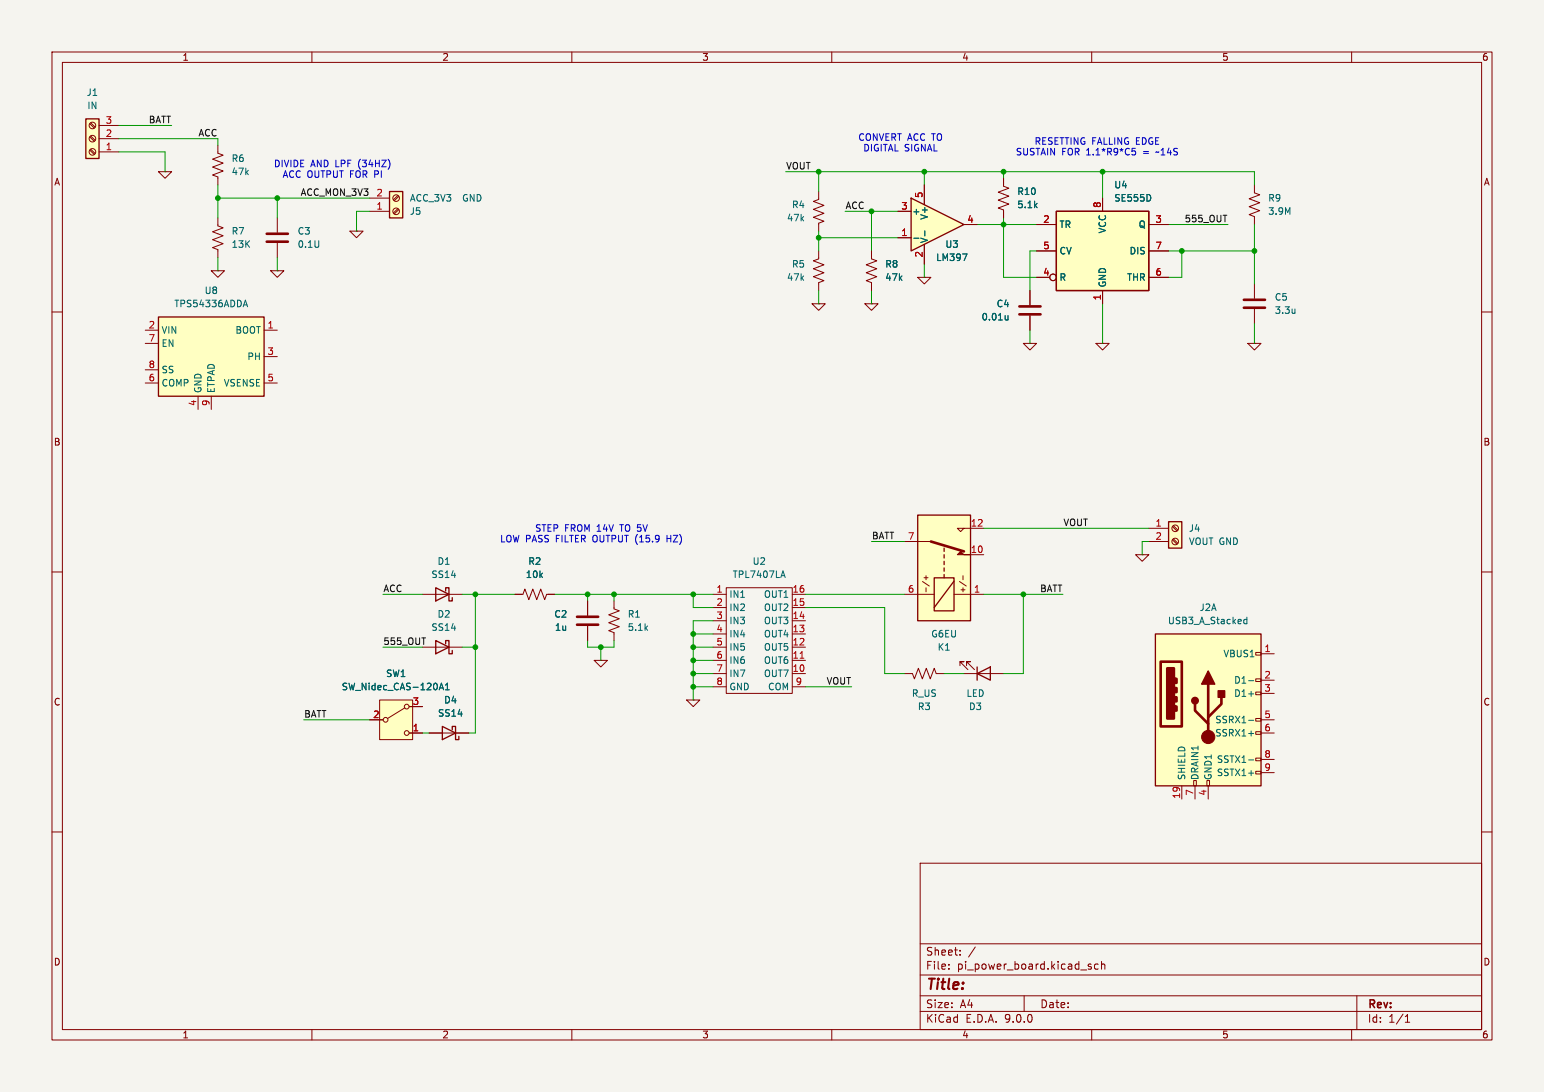
[picture p24: page 1]

LOW PASS FILTER OUTPUT (15.9 HZ) R2
Id: 1/1 Title: File: pi_power_board.kicad_sch Sheet: / R2
