crxguy52/pi-car-power-supply/ltspice/555_monostable.asc

A1: or; Vhigh=12 Vlow=0 Ref=6
ACC2: voltage; PULSE(0 12 0.8 1m 1m 0.8 1 1)
ACC: voltage; PULSE(0 12 0.2 1m 1m 0.1 0.2 2)
BATT: voltage; 12; Rser=0
C1: cap; 1µ
C2: cap; 0.1µ
C3: cap; 100n
C4: cap; 1µ
C5: cap; 0.1µ
C6: cap; 3.3µ
C7: cap; 1µ
D1: diode; 1N4148
R1: res; 500K
R2: res; 100k
R3: res; 10K; tol=10K
R4: res; 10K
R5: res; 3.9Meg
R6: res; 1E3
R7: res; 10k
R8: res; 100k
R10: res; 10E3
S1: sw; SW1
U1: NE555
U2: LT1017
U3: LT1017
U4: NE555
Named nets: 0, OUT_RISE, TRIG_RISE, BATT, ACC, REF, COMP_OUT, RC_RISE, OUT, OUT_FALL, TRIG_FALL, RC_FALL, OUT_RISE_FILT
.tran 0 35 0 1m
.model SW1 SW(Ron=0.001 Roff=10Meg Vt=6 Vh=0.1)
Falling edge delay with reset
Rising edge delay with reset
OR the rising and falling edge outputs
Low pass filter the output to remove edge-edge noise
Create a negative pulse on ACC rising
