crxguy52/pi-car-power-supply/pi_power_board.kicad_pcb

## KiCad design pi_power_board.kicad_pcb (2026-11-09)

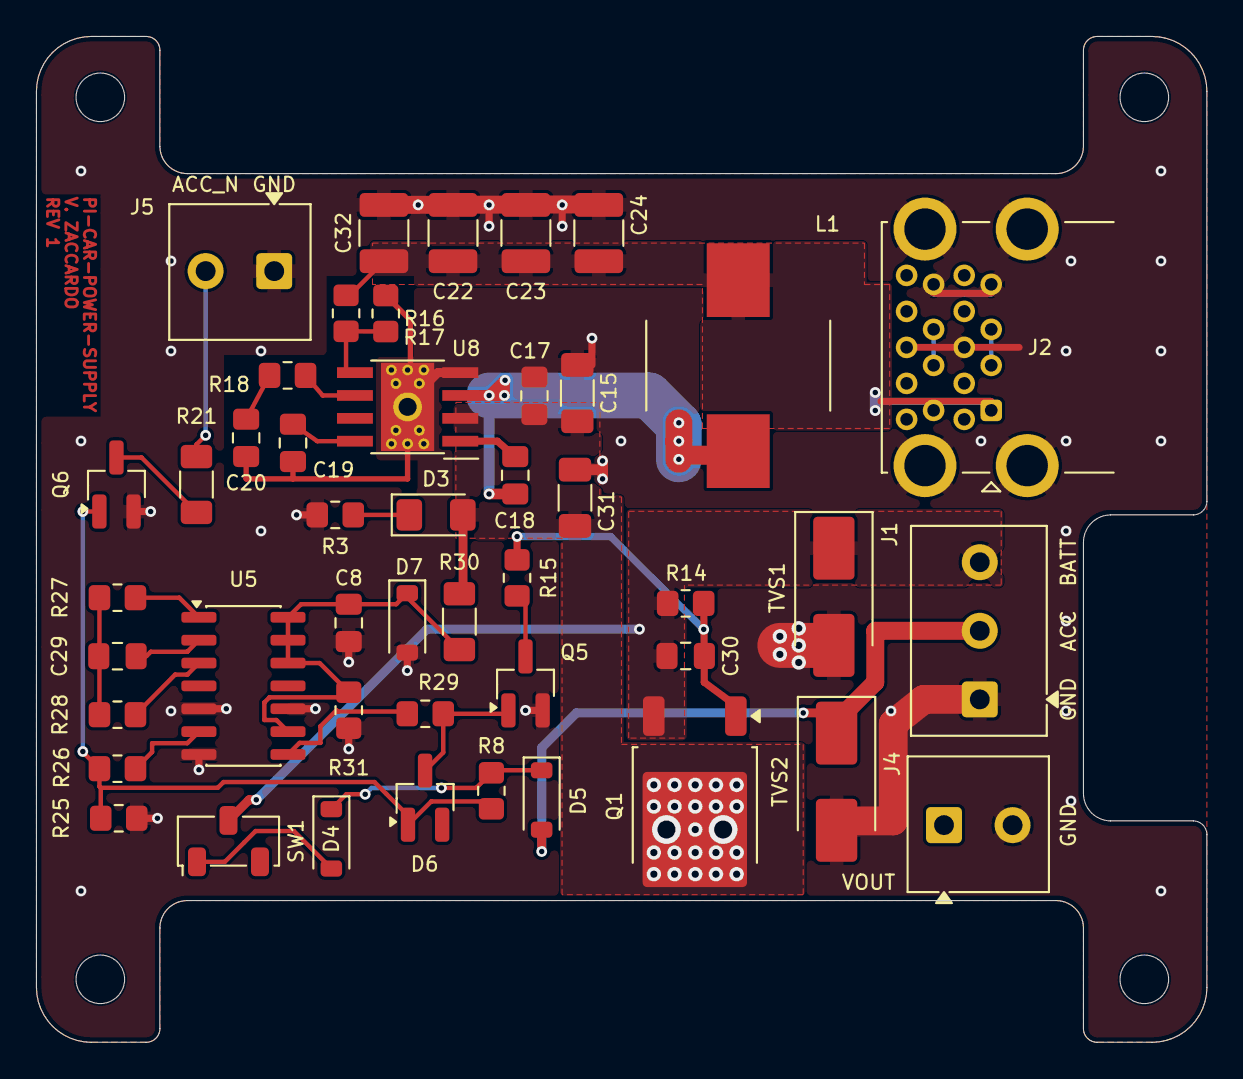
[picture p25: board pi_power_board.kicad_pcb from above]

Board: 2 copper layers, 65.0 x 55.9 mm, 50 parts (0 on the bottom side), 29 nets.

Parts:
C8: 1 µF 50 V; C_0805_2012Metric_Pad1.18x1.45mm_HandSolder
C15, C31: 10 µF 50 V; C_1206_3216Metric_Pad1.33x1.80mm_HandSolder
C17, C18, C30: 100 nF 50 V; C_0805_2012Metric_Pad1.18x1.45mm_HandSolder
C19: 10 nF 50 V; C_0805_2012Metric_Pad1.18x1.45mm_HandSolder
C20: 15 nF 50 V; C_0805_2012Metric_Pad1.18x1.45mm_HandSolder
C22, C23, C24, C32: 47 µF 10 V X7R; C_1210_3225Metric_Pad1.33x2.70mm_HandSolder
C29: 10 nF 50 V C0G ±1 %; C_0805_2012Metric_Pad1.18x1.45mm_HandSolder
D3: VFR1105W; LED_1206_3216Metric_Pad1.42x1.75mm_HandSolder
D4, D5: 1N4148W; D_SOD-123
D6: BAS116LT1G; SOT-23_Handsoldering
D7: BZT52C5V1; D_SOD-123
J1: Screw terminal 3-pos; TerminalBlock_Phoenix_MKDS-1-3-3.81_1x03_P3.81mm_Horizontal
J2: USB3_A_Stacked; USB3_A_Molex_48406-0001_Horizontal_Stacked
J4: Screw terminal 2-pos; TerminalBlock_Phoenix_MKDS-1-2-3.81_1x02_P3.81mm_Horizontal
J5: ACC_N GND; TerminalBlock_Phoenix_MKDS-1-2-3.81_1x02_P3.81mm_Horizontal
L1: SRP1038A-150M; L_Bourns_SRP1038A
MH1, MH2, MH3, MH4: MountingHole_2.7mm_M2.5
Q1: SQD50P04-13L; TO-252-2
Q5, Q6: 2N7002BK; SOT-23_Handsoldering
R3: 5.1 kΩ; R_0805_2012Metric_Pad1.20x1.40mm_HandSolder
R8: 22 kΩ 1 %; R_0805_2012Metric_Pad1.20x1.40mm_HandSolder
R14: 220 kΩ 1 %; R_0805_2012Metric_Pad1.20x1.40mm_HandSolder
R15: 180 kΩ 1 %; R_0805_2012Metric_Pad1.20x1.40mm_HandSolder
R16: 73.2 kΩ 1 %; R_0805_2012Metric_Pad1.20x1.40mm_HandSolder
R17: 13.7 kΩ 1 %; R_0805_2012Metric_Pad1.20x1.40mm_HandSolder
R18: 7.32 kΩ 1 %; R_0805_2012Metric_Pad1.20x1.40mm_HandSolder
R21: 1.5 kΩ; R_1206_3216Metric_Pad1.30x1.75mm_HandSolder
R25: 27 kΩ 1 %; R_0805_2012Metric_Pad1.20x1.40mm_HandSolder
R26: 100 kΩ; R_0805_2012Metric_Pad1.20x1.40mm_HandSolder
R27: 39.2 kΩ 1 %; R_0805_2012Metric_Pad1.20x1.40mm_HandSolder
R28: 78.7 kΩ 1 %; R_0805_2012Metric_Pad1.20x1.40mm_HandSolder
R29: 47 kΩ; R_0805_2012Metric_Pad1.20x1.40mm_HandSolder
R30: 1.3 kΩ 1 %; R_1206_3216Metric_Pad1.30x1.75mm_HandSolder
R31: 10 kΩ 1 %; R_0805_2012Metric_Pad1.20x1.40mm_HandSolder
SW1: SW_Nidec_CAS-120A1; Nidec_Copal_CAS-120A
TVS1, TVS2: SMBJ16A; D_SMB_Handsoldering
U5: CD4541BM96; SOIC-14_3.9x8.7mm_P1.27mm
U8: TPS54336ADDA; TI_DDA_PowerPAD-8_HandSolder

Connections:
/+5V1: C22.1, C23.1, C24.1, C32.1, J2.1, J2.10, L1.2, R16.1
/ACC_G: D6.1, Q6.1, R8.2, R25.1, R26.1
/ACC_IN: D5.2, J1.2, TVS2.1
/ACC_N: J5.2, R21.2
/ACC_S: D4.1, D5.1, R8.1
/BATT: C30.1, J1.3, Q1.3, R14.1, SW1.2, TVS1.1
/D3_K: D3.1, R3.1
/DRV: Q5.3, R15.2
/HOLD_G: D6.3, Q5.1, R29.2
/Q1_G: C30.2, Q1.1, R14.2, R15.1
/STAT_O: Q6.3, R21.1
/SW1_C: D4.2, SW1.1
/U5_CTC: C29.1, U5.2
/U5_MR: R26.2, U5.6
/U5_OUT: R29.1, U5.8
/U5_RS: R28.1, U5.3
/U5_RTC: R27.1, U5.1
/U5_TJ: C29.2, R27.2, R28.2
/U8_BOOT: C18.1, U8.1
/U8_COMP: R18.1, U8.6
/U8_CRC: C20.1, R18.2
/U8_FB: R16.2, R17.1, U8.5
/U8_PH: C18.2, L1.1, U8.3
/U8_SS: C19.1, U8.8
/USB1_D: J2.2, J2.3
/USB2_D: J2.11, J2.12
/VDD_TMR: C8.1, D7.1, R30.2, R31.1, U5.9, U5.12, U5.13, U5.14
/VOUT: C15.1, C17.1, C31.1, D3.2, J4.1, Q1.2, R30.1, U8.2
GND: C8.2, C15.2, C17.2, C19.2, C20.2, C22.2, C23.2, C24.2, C31.2, C32.2, D7.2, J1.1, J2.4, J2.7, J2.13, J2.16, J2.SH, J4.2, J5.1, Q5.2, Q6.2, R3.2, R17.2, R25.2, R31.2, TVS1.2, TVS2.2, U5.5, U5.7, U5.10, U8.4, U8.9
