crxguy52/pi-car-power-supply/(commit log)

2026-11-05 Original KiCad 9 design (pre-agent baseline)
    The project lead's hand-drawn schematic and placed board as of
    2026-04-07, before any agent edits or the KiCad 10 migration
    (from pi_power_board-backups/pre_kicad10_2026-11-04.zip), plus PDF
    exports of the schematic and layout made with KiCad 9.0.
2026-11-06 CD4541B delay-off design: schematic, KiCad sim, routed board, BOM
    Agent-driven redesign from the KiCad 9 baseline (migrated to KiCad 10):
    - Delay-off timer: CD4541B counter powered from VOUT (R30 + 5.1 V zener),
    P-FET high-side switch Q1, N-FET hold/status drivers; >= 25 s worst-case
    hold, ~29.6 s nominal; ~uA parked drain.
    - 5.1 V / 3 A TPS54336A buck for dual USB-A, values and layout per
    SLVSCD5D (L1 15 uH, Cin/Cout added, FB divider at pin 5).
    - KiCad-native simulation (simulation.kicad_sch, lib/spice, run_sim.py).
    - Board placed and routed on 2 layers to OSH Park rules; right-edge notch
    for the CAN HAT back header; DRC 0 errors / 0 unconnected / 0 parity.
    - BOM with Digi-Key cut-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
2026-11-09 Lead layout review: schematic tidy, buck edits, refs on silk, thermals
    - Schematic rearranged for readability (lead, GUI); netlist identical.
    - Buck layout edits (lead, GUI): output caps beside U8/R16, L1 turned,
    third PH via, C17 closer to U8, R17 back inside AGND_KEEPOUT.
    - post_route/17: F.Fab references to silk (C18/R16 hand-placed by the
    lead); micro-segment track debris removed with clearance-checked snaps.
    - post_route/18: thermal reliefs on pads in every pour; solid kept on
    U8, Q1, C17 and C32 pad 1.
    - Docs: DECISIONS, TODO, HANDOFF, post_route README, CLAUDE.md.
    DRC 0 errors / 0 unconnected / 0 parity (1 accepted J4 silk warning);
    check_fixed PASS; verify-sch PASS.
